OPSORO/Ono2/Other components/RaspberryPi-B+/raspberry_pi_B+_(RENDER).JPG

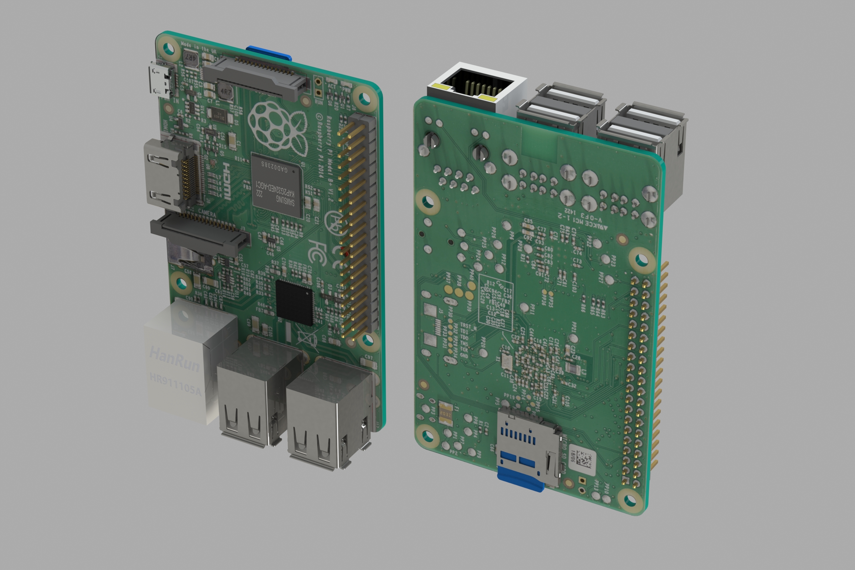
Other components/RaspberryPi-B+/raspberry_pi_B+_(RENDER).JPG
