OPSORO/Ono2/Other components/RaspberryPi-B+/raspberry_pi_B+_(gif).gif

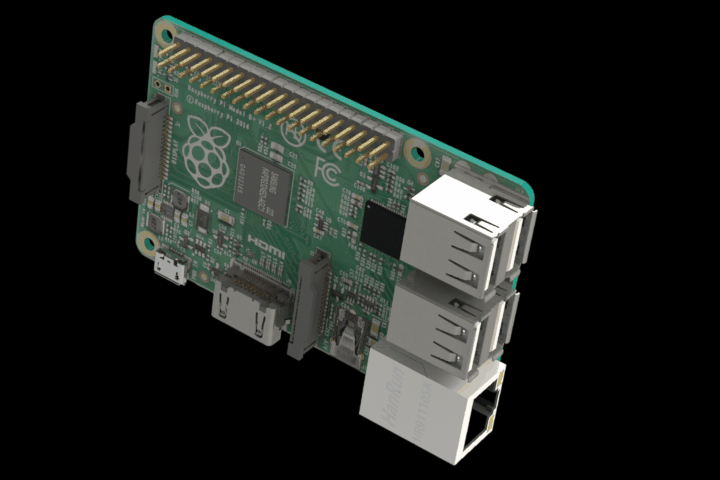
Other components/RaspberryPi-B+/raspberry_pi_B+_(gif).gif
