OPSORO/Ono2/Eye/eye.sldasm

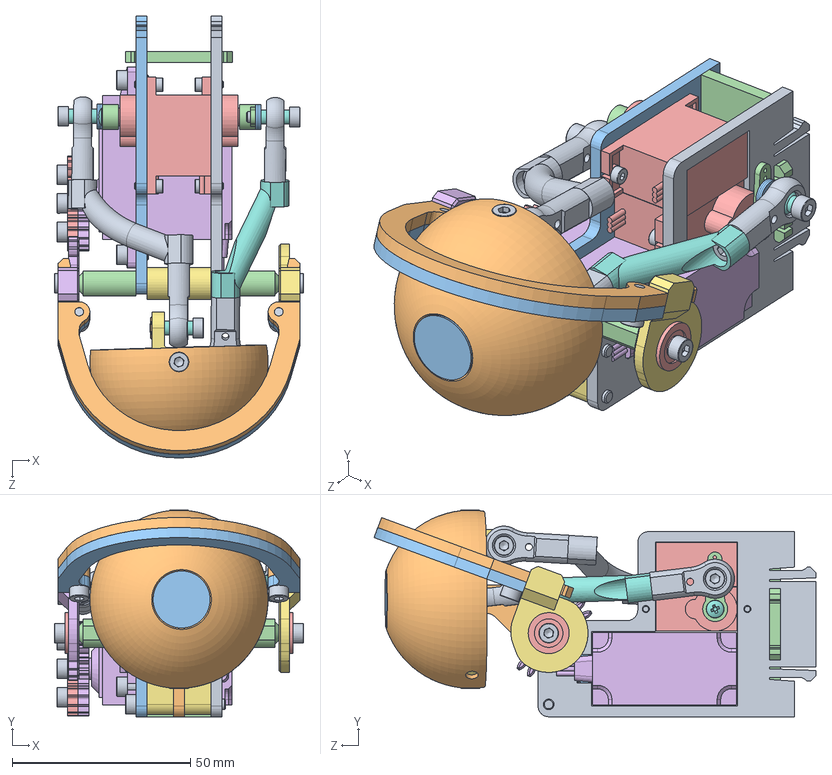
[picture p3: CAD file, 2015-08-11]
Eye/eye.sldasm
70.0 x 58.0 x 124.0 mm
eye-frame-2
eye-frame-4
eye-frame-1
eye-frame-3
servo-micro x 2
servo-standard
pivot-beam
balljoint-ball x 4
balljoint-housing x 4
eye-shell
iris
eyelid-spacer x 2
bearing-f623 x 2
eyelid-gear
eyelid-idler
lever-horizontal
lever-vertical
eyelid
eyelid-lower
servo-horn-micro-1-arm x 2
eyelid-servo-gear-lasered-a
eyelid-servo-gear-lasered-b
eye-frame-spacer x 2
pan head cross recess screw_iso x 2
socket head cap screw_iso x 30
hex nut style 1 gradeab_iso x 7
plain washer normal grade a_iso x 10
