OPSORO/Ono2/Frame/frame-laser.SLDASM

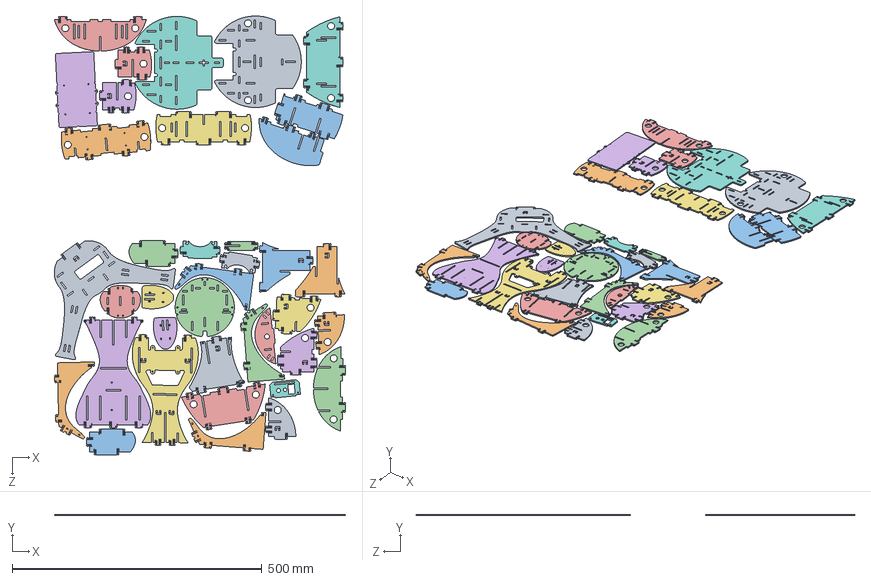
[picture p4: CAD file, 2015-10-12]
Frame/frame-laser.SLDASM
583.5 x 3.00 x 878.7 mm
frame-1-1
frame-1-10
frame-1-2
frame-1-3
frame-1-4
frame-1-5
frame-1-6
frame-1-7
frame-1-8
frame-1-9
frame-1-11
frame-1-12
frame-1-13
frame-1-14
frame-1-15
frame-1-16
frame-1-17
frame-1-18
frame-1-19
frame-2-1
frame-2-2
frame-2-3
frame-2-4
frame-2-5
frame-3-1
frame-3-2
frame-3-3
frame-3-4
frame-3-5
frame-3-6
frame-3-7
frame-4-1
frame-4-2
frame-4-3
frame-4-4
frame-4-5
frame-4-6
frame-5-1
