OPSORO/Ono2/Other components/Workshop-base/workshop-base.SLDASM

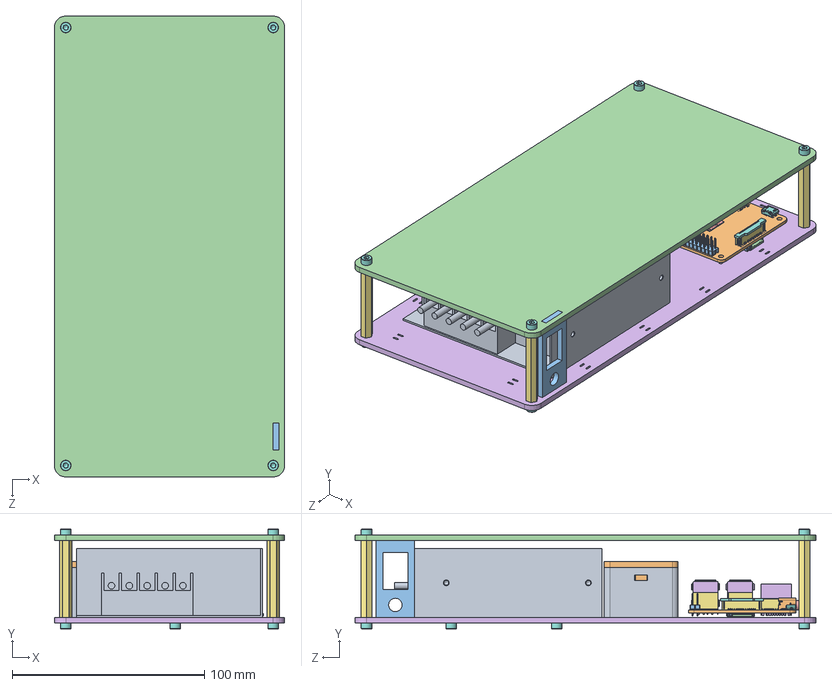
[picture p5: CAD file, 2015-02-17]
Other components/Workshop-base/workshop-base.SLDASM
120.0 x 52.0 x 240.0 mm
psu-tdk-ls50-5
psu-vtx-214-010-105
raspberry_pi_B+_(bar_180_2x20)
raspberry_pi_B+_(QFN64)
raspberry_pi_B+_(168_FBGA_12x12)
raspberry_pi_B+_(USB_x2_part1) x 2
raspberry_pi_B+_(USB_x2_part2) x 2
raspberry_pi_B+_(micro_USB_cover)
raspberry_pi_B+_(micro_USB_contacts)
raspberry_pi__HDMI_socket_cover
raspberry_pi__HDMI_socket_inside
raspberry_pi__HDMI_socket_large_pin x 10
raspberry_pi__HDMI_socket_small_pin x 9
raspberry_pi_B+_(RJ45)
raspberry_pi__15_pin_FFC_Connector_body x 2
raspberry_pi__15_pin_FFC_Connector_locker x 2
raspberry_pi__15_pin_FFC_Connector_pins x 30
raspberry_pi_B+_(CI_Board)
raspberry_pi_B+_(microsd_slot2)
raspberry_pi_B+_(microsd2)
raspberry_pi_B+_(audio_video2)
midplate
standoff-m3x40 x 4
socket head cap screw_iso x 14
psu-spacer x 2
psu-cover
switch-plate
coverplate
