OPSORO/Ono2/Other components/RaspberryPi-B+/raspberry_pi_B+_(microsd).SLDASM

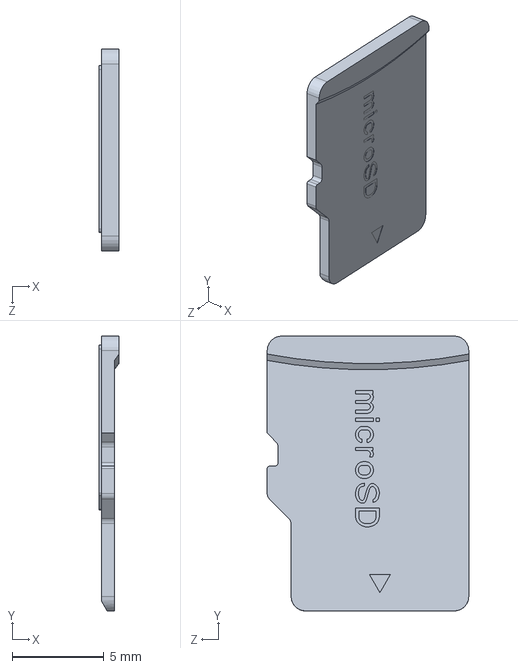
[picture p7: CAD file, 2015-02-17]
Other components/RaspberryPi-B+/raspberry_pi_B+_(microsd).SLDASM
1.10 x 15.0 x 11.0 mm
