OPSORO/Ono2/Other components/RaspberryPi-B+/raspberry_pi_B+_(slot).SLDASM

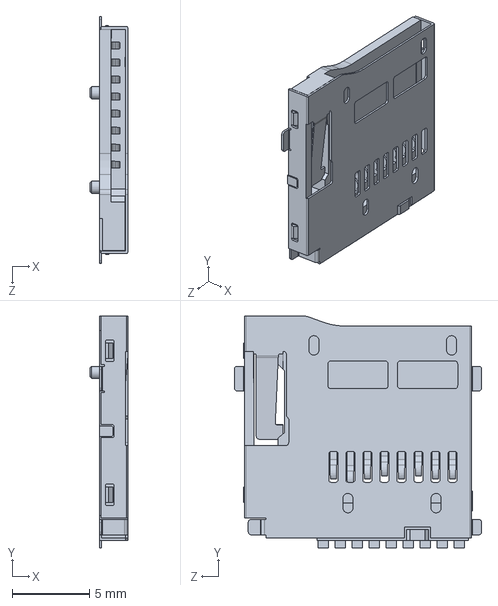
[picture p8: CAD file, 2015-02-17]
Other components/RaspberryPi-B+/raspberry_pi_B+_(slot).SLDASM
2.44 x 15.0 x 16.0 mm
