OPSORO/Ono2/Other components/RaspberryPi-B+/raspberry_pi_B+_(15_pin_FFC_Connector).SLDASM

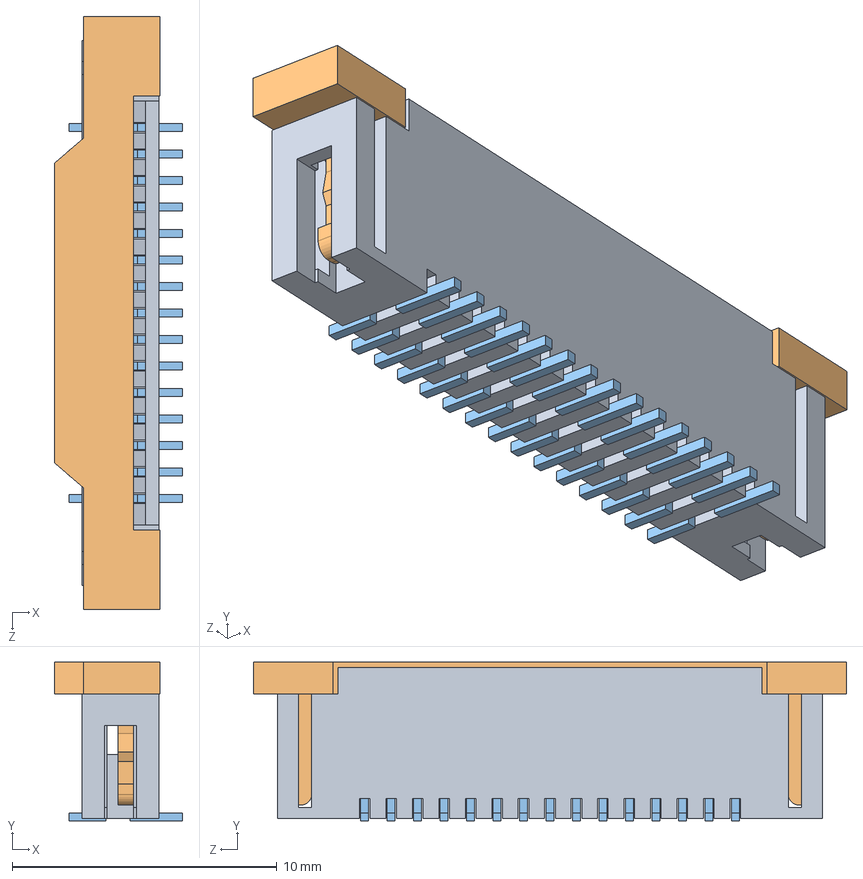
[picture p9: CAD file, 2015-02-17]
Other components/RaspberryPi-B+/raspberry_pi_B+_(15_pin_FFC_Connector).SLDASM
4.85 x 6.00 x 22.4 mm
raspberry_pi__15_pin_FFC_Connector_body
raspberry_pi__15_pin_FFC_Connector_locker
raspberry_pi__15_pin_FFC_Connector_pins x 15
