OPSORO/Ono2/Other components/RaspberryPi-B+/raspberry_pi_B+_(microsd_slot).SLDASM

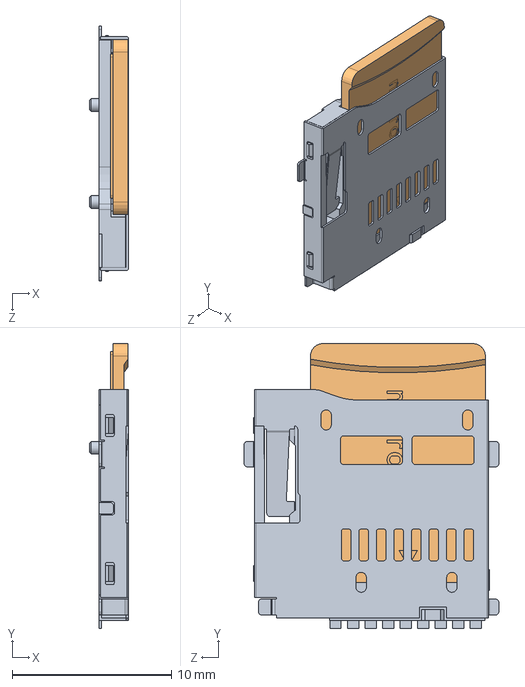
[picture p10: CAD file, 2015-02-17]
Other components/RaspberryPi-B+/raspberry_pi_B+_(microsd_slot).SLDASM
2.44 x 17.9 x 16.0 mm
raspberry_pi_B+_(slot)
raspberry_pi_B+_(microsd)
