OPSORO/Ono2/Other components/RaspberryPi-B+/raspberry_pi_B+_(micro_USB).SLDASM

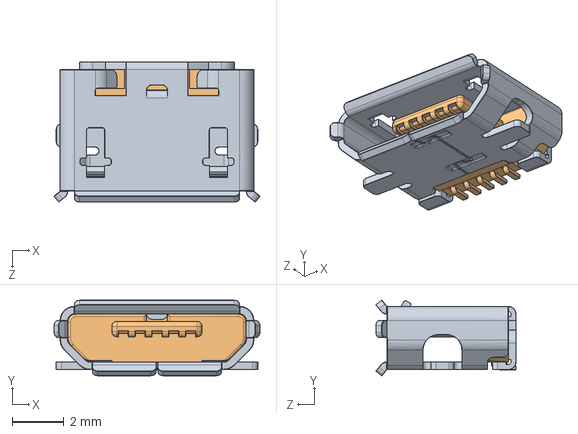
[picture p11: CAD file, 2015-02-17]
Other components/RaspberryPi-B+/raspberry_pi_B+_(micro_USB).SLDASM
7.97 x 2.92 x 5.43 mm
raspberry_pi_B+_(micro_USB_cover)
raspberry_pi_B+_(micro_USB_contacts)
