OPSORO/Ono2/Other components/RaspberryPi-B+/raspberry_pi_B+_(USB_x2).SLDASM

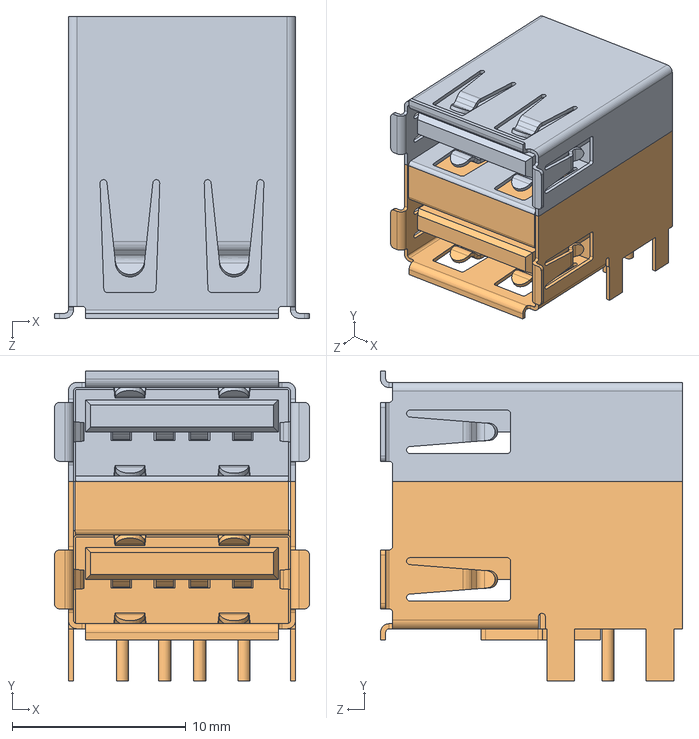
[picture p13: CAD file, 2015-02-17]
Other components/RaspberryPi-B+/raspberry_pi_B+_(USB_x2).SLDASM
14.7 x 17.9 x 17.4 mm
raspberry_pi_B+_(USB_x2_part1)
raspberry_pi_B+_(USB_x2_part2)
