OPSORO/Ono2/STL/ono - raspberrypi_b_+_(assembly)-1 raspberry_pi_B+_(RJ45)-1-1.STL

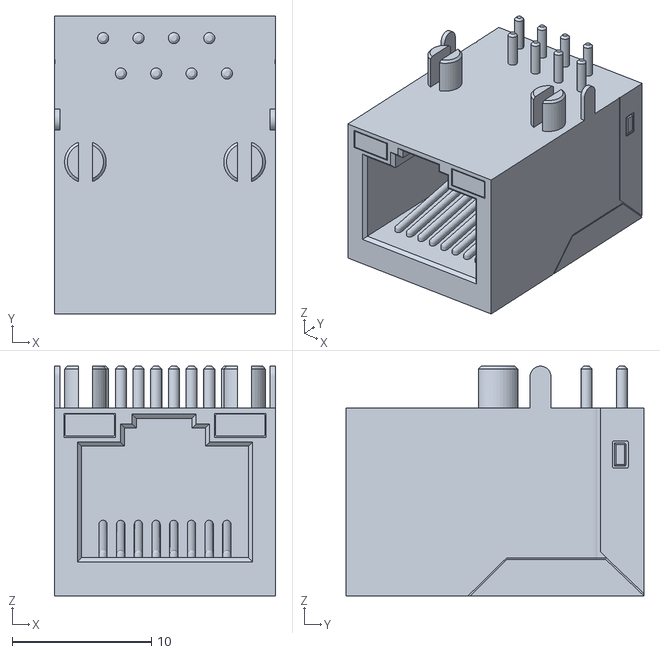
[picture p14: CAD file, 2015-08-11]
STL/ono - raspberrypi_b_+_(assembly)-1 raspberry_pi_B+_(RJ45)-1-1.STL
15.9 x 21.4 x 16.5
