OPSORO/Ono2/STL/ono - raspberrypi_b_+_(assembly)-1 raspberry_pi_B+_(audio_video2)-1-1.STL

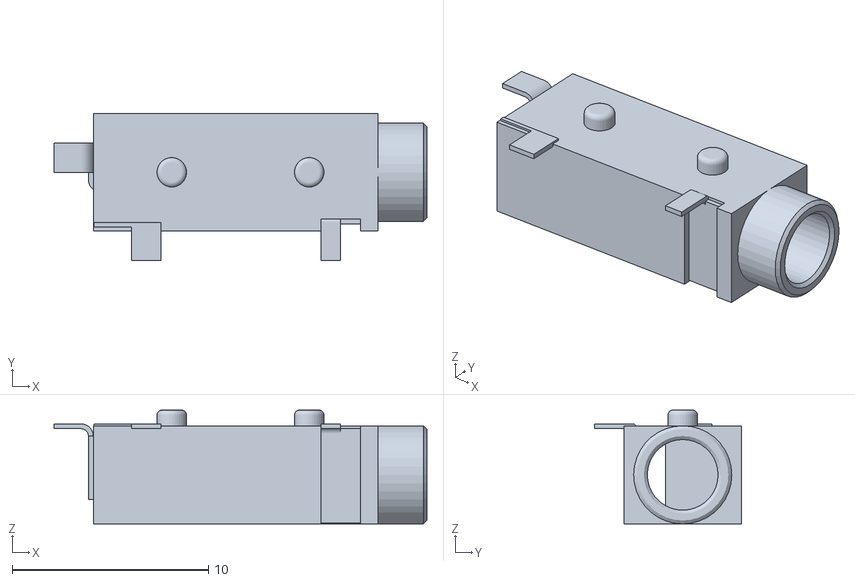
[picture p16: CAD file, 2015-08-11]
STL/ono - raspberrypi_b_+_(assembly)-1 raspberry_pi_B+_(audio_video2)-1-1.STL
19.0 x 7.50 x 5.80
