OPSORO/Ono2/STL/ono - raspberrypi_b_+_(assembly)-1 raspberry_pi_B+_(microsd2)-1-1.STL

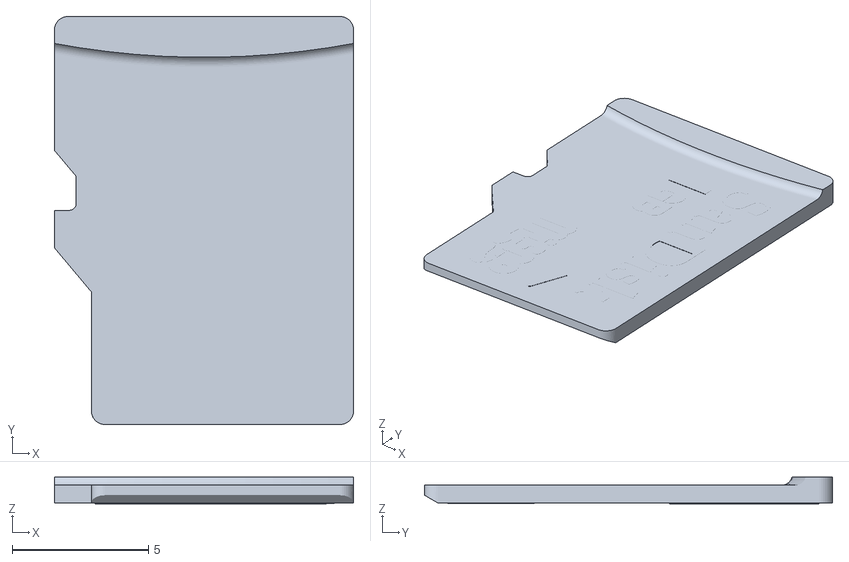
[picture p17: CAD file, 2015-08-11]
STL/ono - raspberrypi_b_+_(assembly)-1 raspberry_pi_B+_(microsd2)-1-1.STL
11.0 x 15.0 x 0.975
