OPSORO/Ono2/STL/ono - raspberrypi_b_+_(assembly)-1 raspberry_pi_B+_(microsd_slot2)-1-1.STL

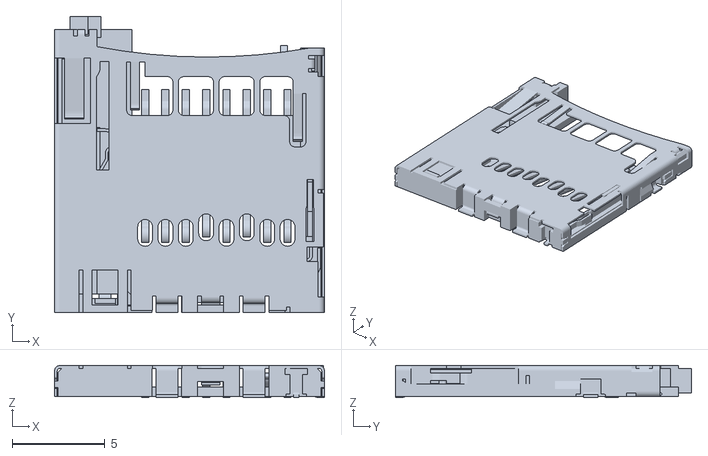
[picture p18: CAD file, 2015-08-11]
STL/ono - raspberrypi_b_+_(assembly)-1 raspberry_pi_B+_(microsd_slot2)-1-1.STL
14.6 x 16.0 x 1.73
