OPSORO/Ono2/STL/ono - raspberrypi_b_+_(assembly)-1 raspberry_pi_B+_(CI_Board)-1-1.STL

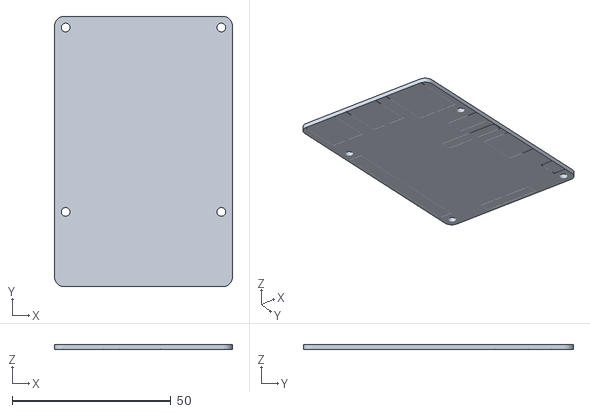
[picture p19: CAD file, 2015-08-11]
STL/ono - raspberrypi_b_+_(assembly)-1 raspberry_pi_B+_(CI_Board)-1-1.STL
56.0 x 85.0 x 1.60
