OPSORO/Ono2/STL/ono - raspberrypi_b_+_(assembly)-1 raspberry_pi_B+_(QFN64)-1-1.STL

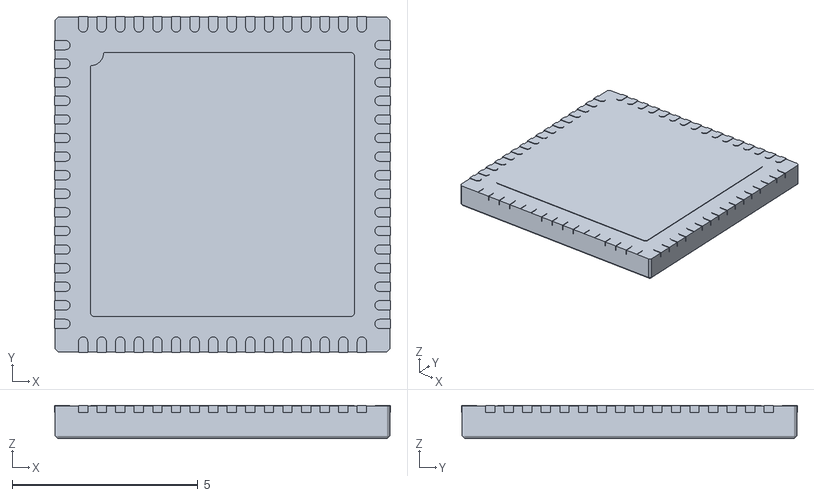
[picture p20: CAD file, 2015-08-11]
STL/ono - raspberrypi_b_+_(assembly)-1 raspberry_pi_B+_(QFN64)-1-1.STL
9.04 x 9.04 x 0.9
