OPSORO/Ono2/STL/ono - raspberrypi_b_+_(assembly)-1 raspberry_pi_B+_(bar_180_2x20)-1-1.STL

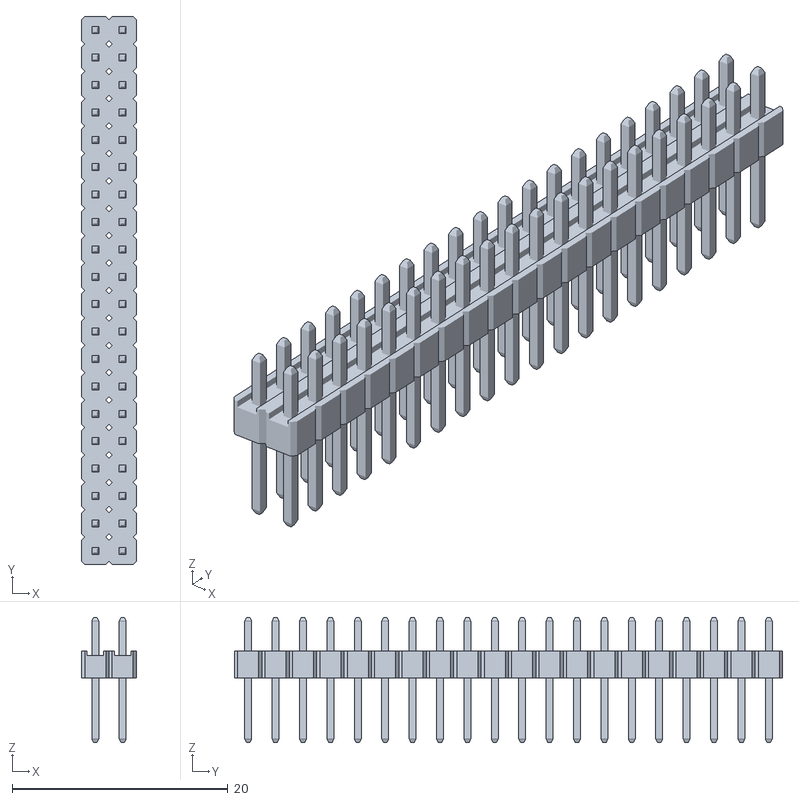
[picture p21: CAD file, 2015-08-11]
STL/ono - raspberrypi_b_+_(assembly)-1 raspberry_pi_B+_(bar_180_2x20)-1-1.STL
5.08 x 50.8 x 11.6
