OPSORO/Ono2/STL/ono - raspberrypi_b_+_(assembly)-1 raspberry_pi_B+_(HDMI_socket)-1 raspberry_pi__HDMI_socket_large_pin-2-1.STL

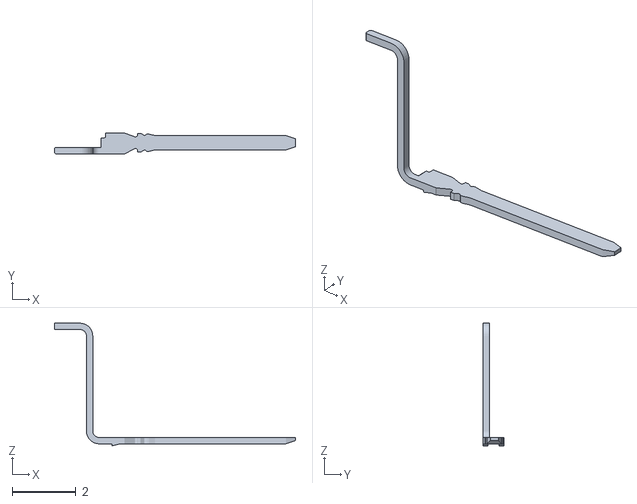
[picture p22: CAD file, 2015-08-07]
STL/ono - raspberrypi_b_+_(assembly)-1 raspberry_pi_B+_(HDMI_socket)-1 raspberry_pi__HDMI_socket_large_pin-2-1.STL
7.55 x 0.65 x 3.84
