OPSORO/Ono2/STL/ono - raspberrypi_b_+_(assembly)-1 raspberry_pi_B+_(15_pin_FFC_Connector)-1 raspberry_pi__15_pin_FFC_Connector_body-1-1.STL

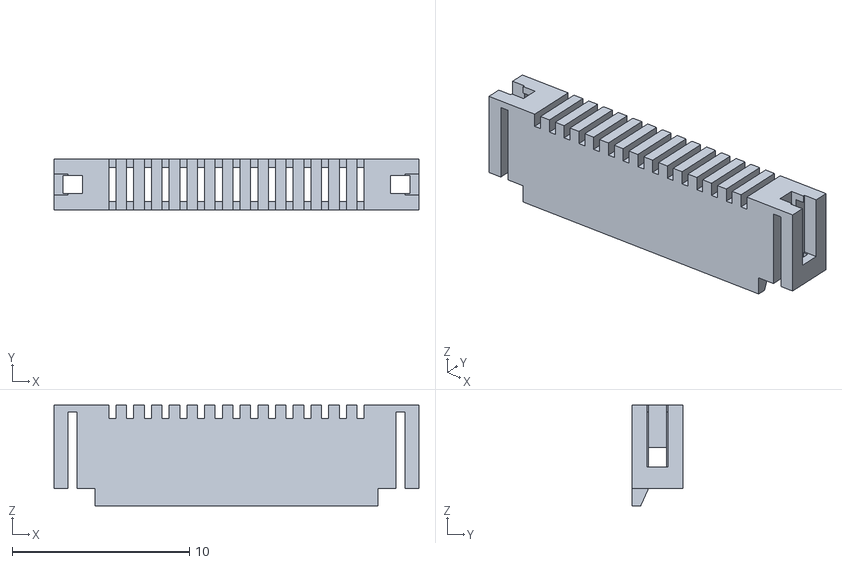
[picture p23: CAD file, 2015-08-07]
STL/ono - raspberrypi_b_+_(assembly)-1 raspberry_pi_B+_(15_pin_FFC_Connector)-1 raspberry_pi__15_pin_FFC_Connector_body-1-1.STL
20.6 x 2.90 x 5.70
