OPSORO/Ono2/STL/ono - raspberrypi_b_+_(assembly)-1 raspberry_pi_B+_(15_pin_FFC_Connector)-2 raspberry_pi__15_pin_FFC_Connector_pins-11-1.STL

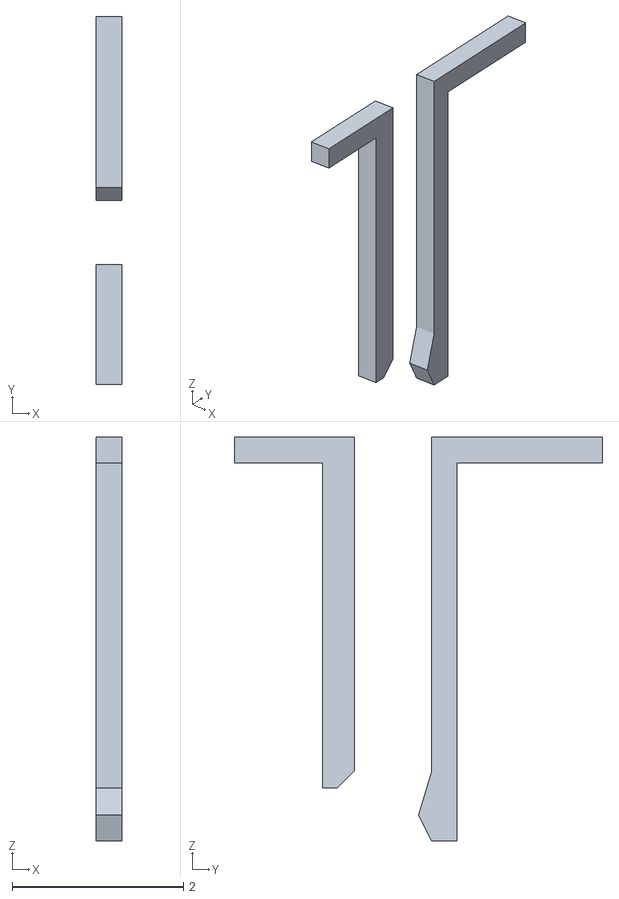
[picture p24: CAD file, 2015-08-07]
STL/ono - raspberrypi_b_+_(assembly)-1 raspberry_pi_B+_(15_pin_FFC_Connector)-2 raspberry_pi__15_pin_FFC_Connector_pins-11-1.STL
0.3 x 4.30 x 4.71
