OPSORO/Ono2/STL/ono - raspberrypi_b_+_(assembly)-1 raspberry_pi_B+_(HDMI_socket)-1 raspberry_pi__HDMI_socket_cover-1-1.STL

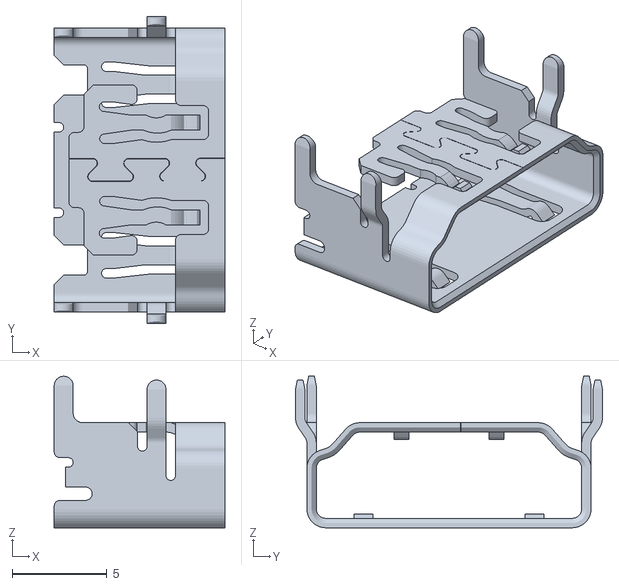
[picture p25: CAD file, 2015-08-07]
STL/ono - raspberrypi_b_+_(assembly)-1 raspberry_pi_B+_(HDMI_socket)-1 raspberry_pi__HDMI_socket_cover-1-1.STL
9.00 x 16.2 x 8.00
