OPSORO/Ono2/STL/ono - raspberrypi_b_+_(assembly)-1 raspberry_pi_B+_(USB_x2)-2 raspberry_pi_B+_(USB_x2_part1)-1-1.STL

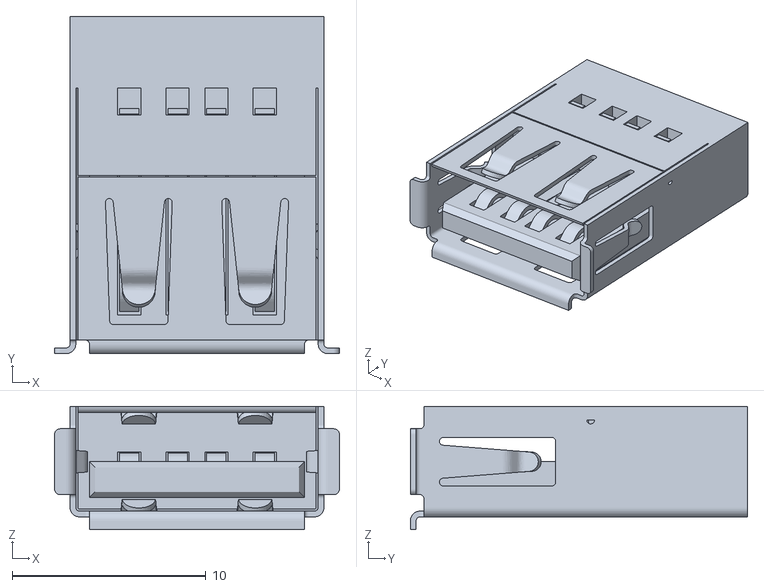
[picture p26: CAD file, 2015-08-07]
STL/ono - raspberrypi_b_+_(assembly)-1 raspberry_pi_B+_(USB_x2)-2 raspberry_pi_B+_(USB_x2_part1)-1-1.STL
14.7 x 17.4 x 6.35
