OPSORO/Ono2/STL/ono - raspberrypi_b_+_(assembly)-1 raspberry_pi_B+_(15_pin_FFC_Connector)-2 raspberry_pi__15_pin_FFC_Connector_locker-1-1.STL

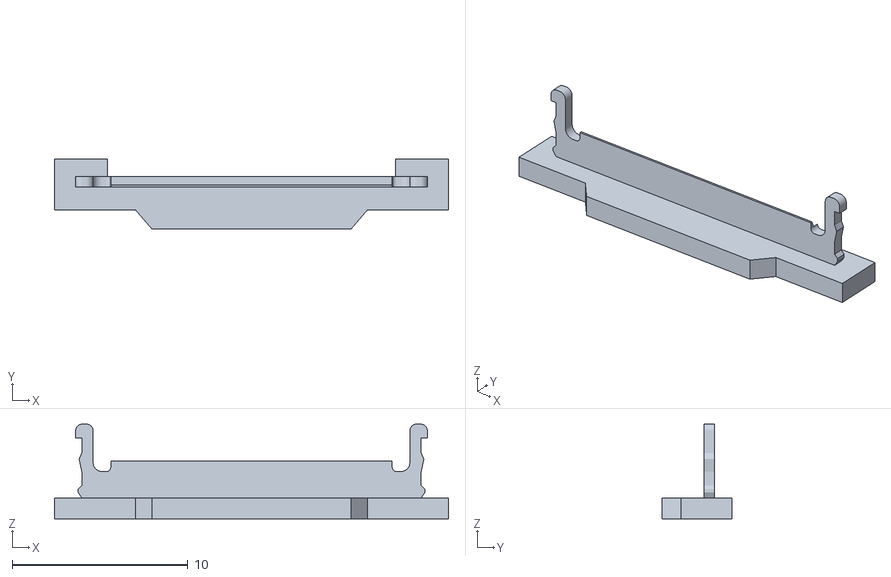
[picture p28: CAD file, 2015-08-07]
STL/ono - raspberrypi_b_+_(assembly)-1 raspberry_pi_B+_(15_pin_FFC_Connector)-2 raspberry_pi__15_pin_FFC_Connector_locker-1-1.STL
22.4 x 4.00 x 5.40
