OPSORO/Ono2/STL/ono - raspberrypi_b_+_(assembly)-1 raspberry_pi_B+_(micro_USB)-1 raspberry_pi_B+_(micro_USB_contacts)-1-1.STL

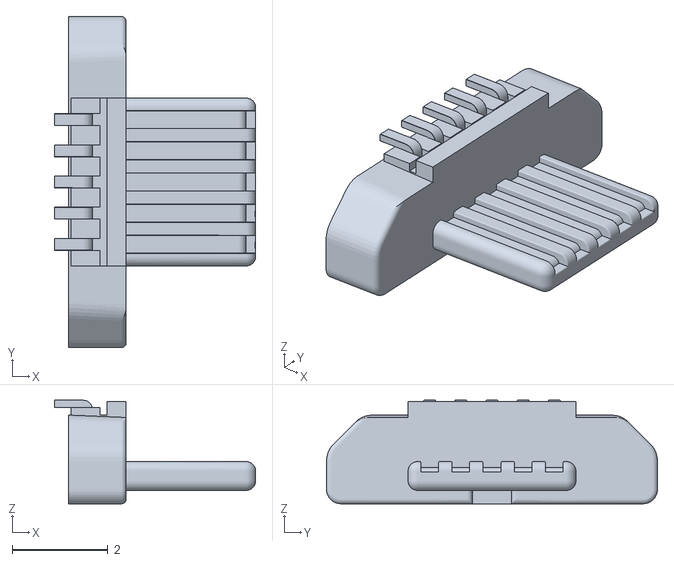
[picture p30: CAD file, 2015-08-07]
STL/ono - raspberrypi_b_+_(assembly)-1 raspberry_pi_B+_(micro_USB)-1 raspberry_pi_B+_(micro_USB_contacts)-1-1.STL
4.20 x 6.90 x 2.16
