OPSORO/Ono2/STL/ono - raspberrypi_b_+_(assembly)-1 raspberry_pi_B+_(HDMI_socket)-1 raspberry_pi__HDMI_socket_inside-1-1.STL

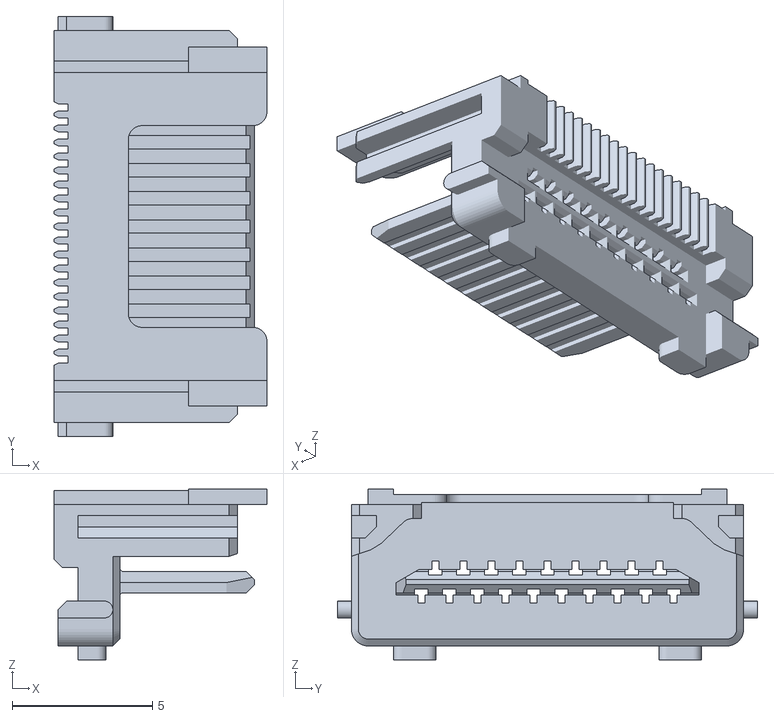
[picture p31: CAD file, 2015-08-07]
STL/ono - raspberrypi_b_+_(assembly)-1 raspberry_pi_B+_(HDMI_socket)-1 raspberry_pi__HDMI_socket_inside-1-1.STL
7.60 x 15.0 x 6.10
