OPSORO/Ono2/STL/ono - raspberrypi_b_+_(assembly)-1 raspberry_pi_B+_(micro_USB)-1 raspberry_pi_B+_(micro_USB_cover)-1-1.STL

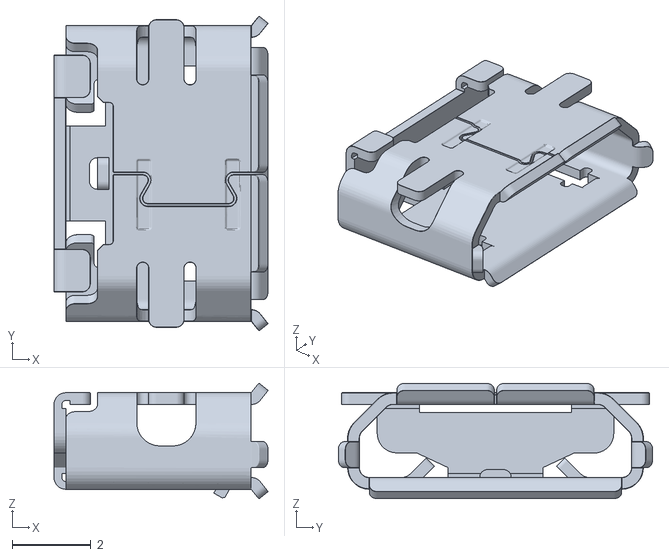
[picture p32: CAD file, 2015-08-07]
STL/ono - raspberrypi_b_+_(assembly)-1 raspberry_pi_B+_(micro_USB)-1 raspberry_pi_B+_(micro_USB_cover)-1-1.STL
5.43 x 7.97 x 2.92
