OPSORO/Ono2/Eye/DXF/eye-laser.dxf

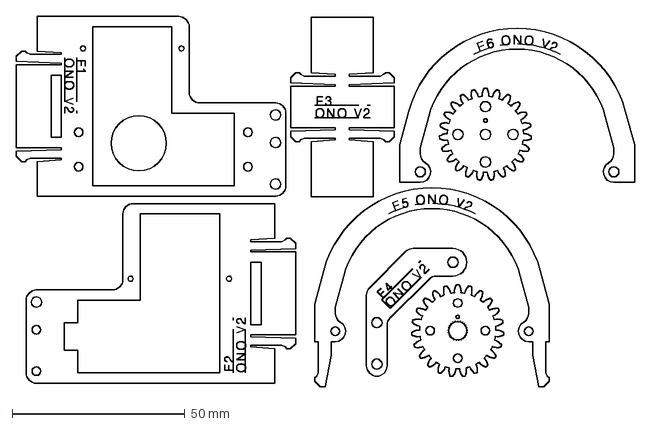
[picture p33: CAD file, 2015-08-11]
Eye/DXF/eye-laser.dxf
178.9 x 107.1 mm
