OPSORO/Ono2/Eye/STEP/eyelid-idler-r.step

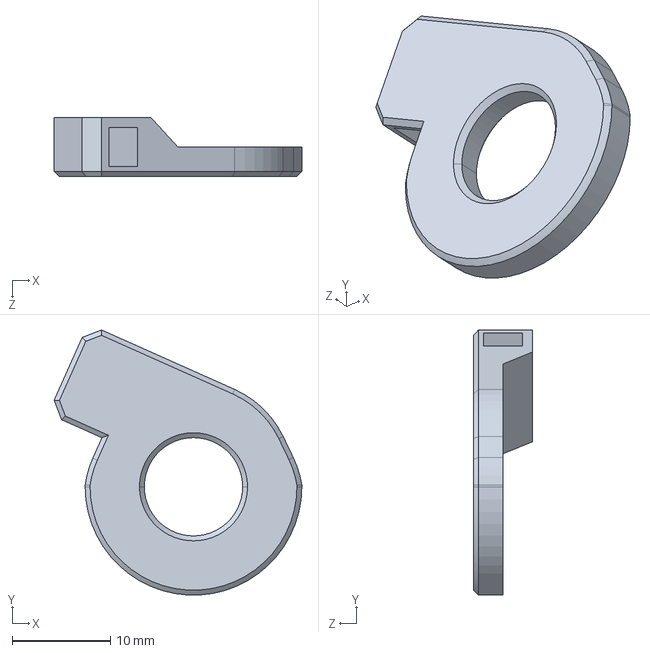
[picture p34: CAD file, 2015-08-11]
Eye/STEP/eyelid-idler-r.step
25.2 x 27.0 x 6.00 mm
