OPSORO/Ono2/Eye/STL/eye - eye-frame-spacer-3.STL

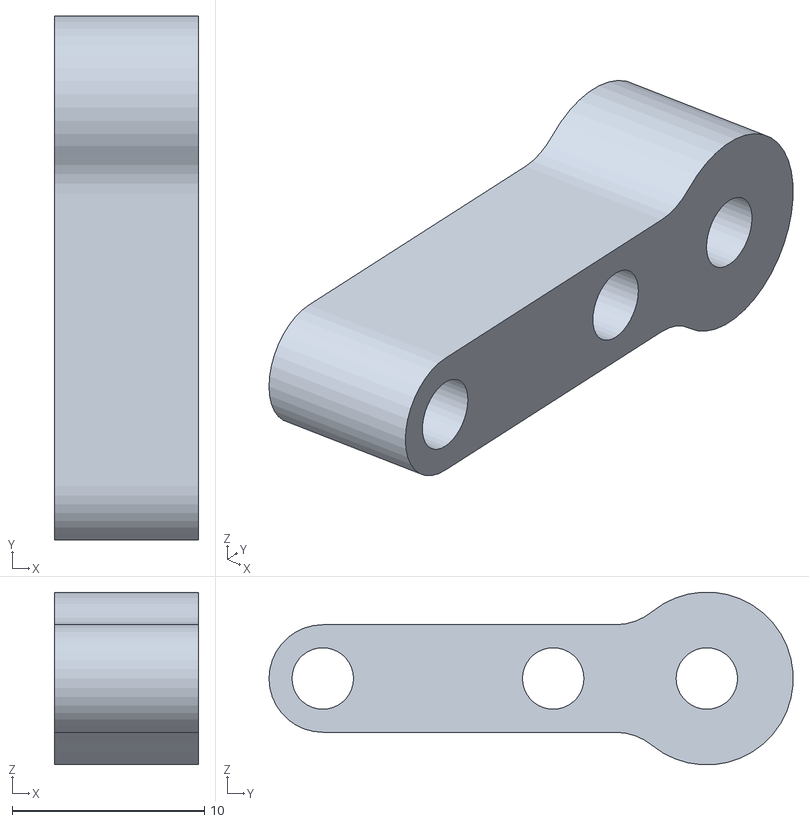
[picture p35: CAD file, 2015-08-11]
Eye/STL/eye - eye-frame-spacer-3.STL
7.50 x 27.3 x 8.98
