OPSORO/Ono2/Eyebrow/DXF/eyebrow-laser.dxf

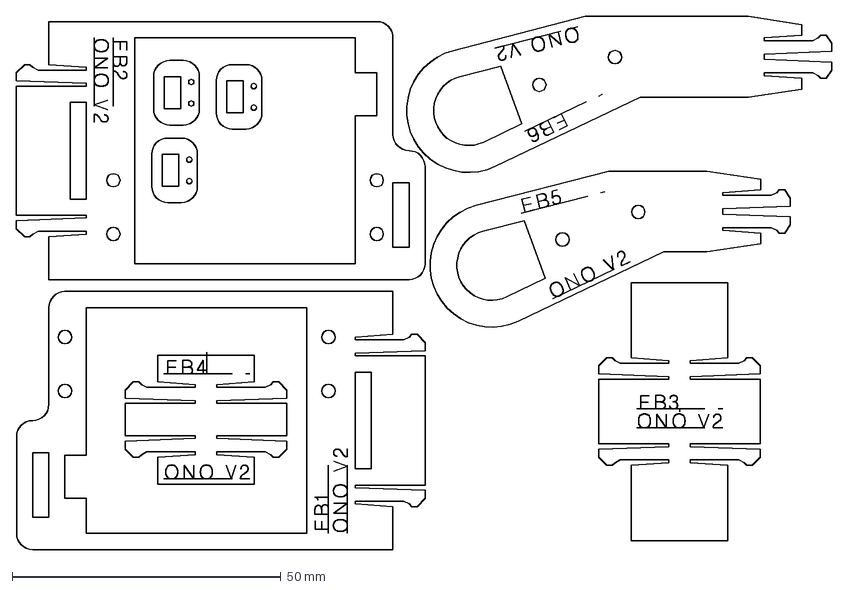
[picture p36: CAD file, 2015-08-11]
Eyebrow/DXF/eyebrow-laser.dxf
151.6 x 99.1 mm
