OPSORO/Ono2/Eyebrow/lever-outer-towerpro-horn.SLDPRT

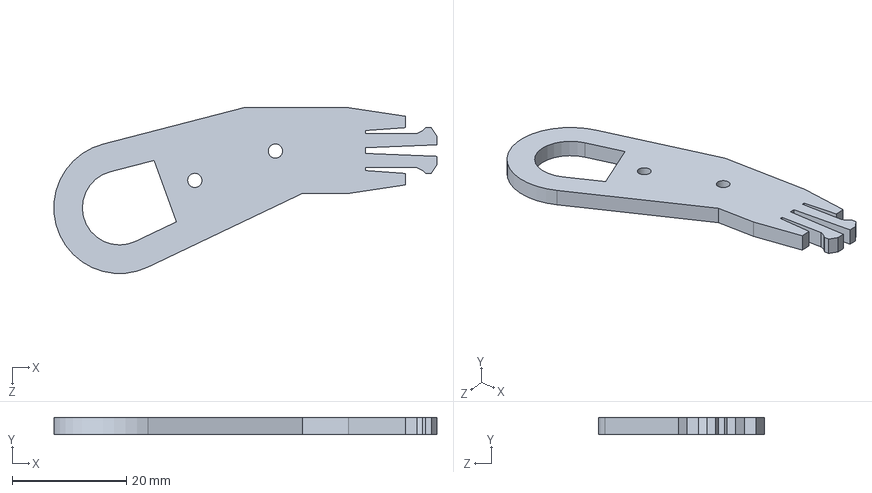
[picture p37: CAD file, 2015-08-10]
Eyebrow/lever-outer-towerpro-horn.SLDPRT
67.0 x 3.00 x 29.0 mm
