OPSORO/Ono2/Eyebrow/STEP/eyebrow.step

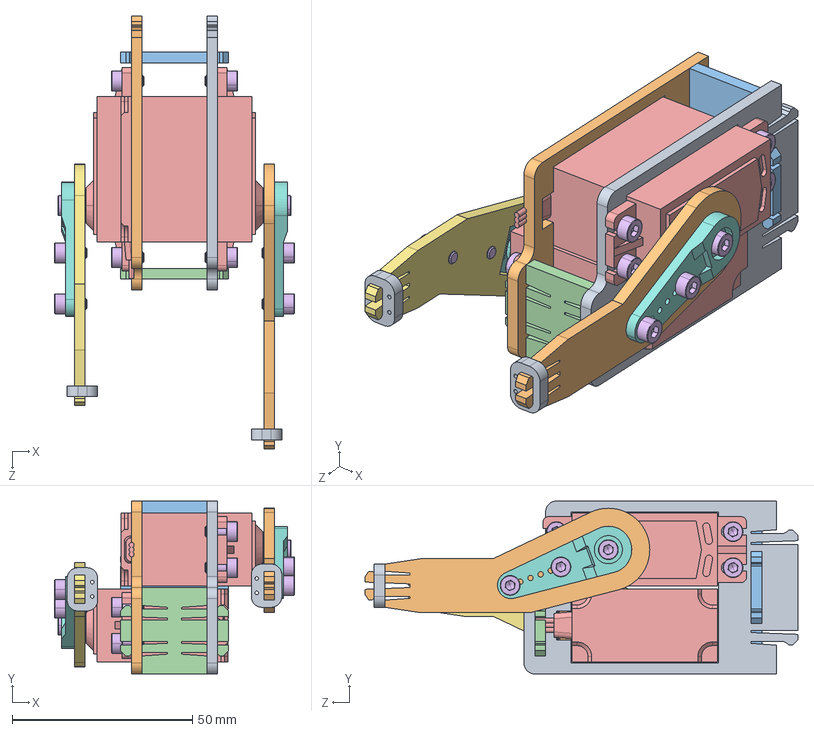
[picture p38: CAD file, 2015-08-10]
Eyebrow/STEP/eyebrow.step
66.6 x 48.0 x 120.1 mm
eyebrow-frame-1
eyebrow-frame-2
eyebrow-frame-3
eyebrow-frame-4
servo-standard x 2
socket head cap screw_iso_ISO 4762 M3 x 6 --- 6N x 14
lever-outer-towerpro-horn
servo-horn-towerpro-1-arm x 2
textile-snap x 2
lever-inner-towerpro-horn
