OPSORO/Ono2/Eyebrow/STL/eyebrow - eyebrow-frame-1-1.STL

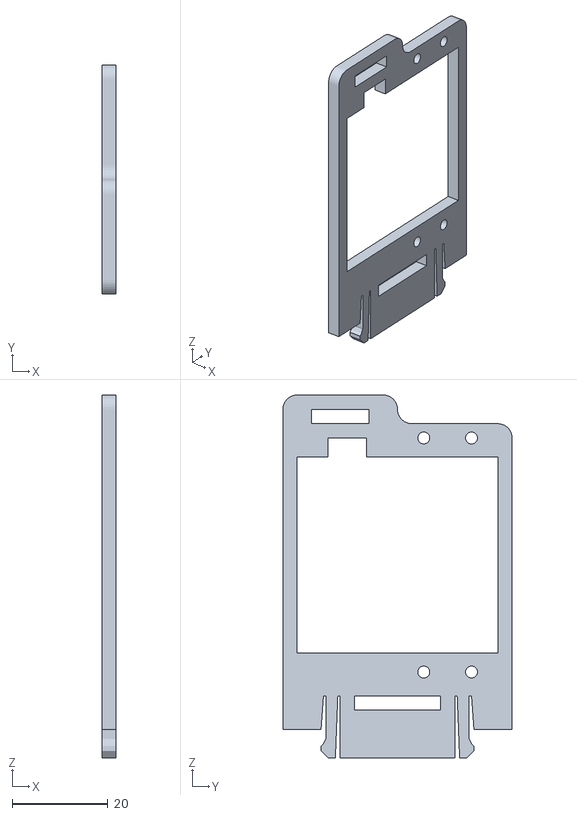
[picture p39: CAD file, 2015-08-10]
Eyebrow/STL/eyebrow - eyebrow-frame-1-1.STL
3.00 x 48.0 x 76.0
