OPSORO/Ono2/Frame/STEP/psu-spacer-new.step

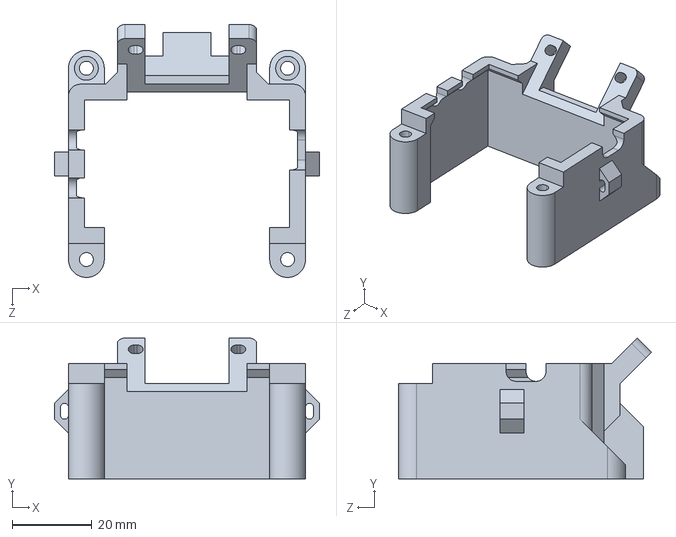
[picture p40: CAD file, 2015-08-07]
Frame/STEP/psu-spacer-new.step
66.5 x 35.4 x 63.5 mm
