OPSORO/Ono2/Mouth/DXF/mouth-laser.dxf

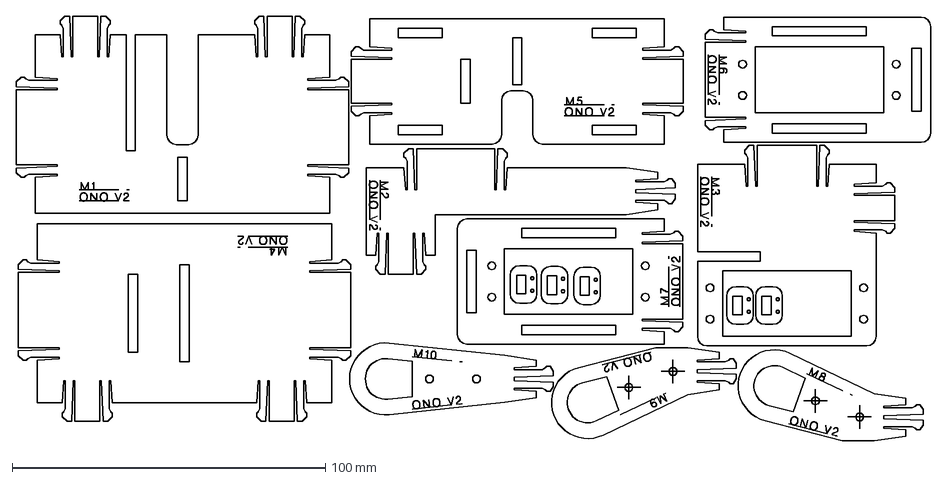
[picture p41: CAD file, 2015-10-12]
Mouth/DXF/mouth-laser.dxf
291.8 x 135.6 mm
