OPSORO/Ono2/Mouth/lever-mid-towerpro-horn.SLDPRT

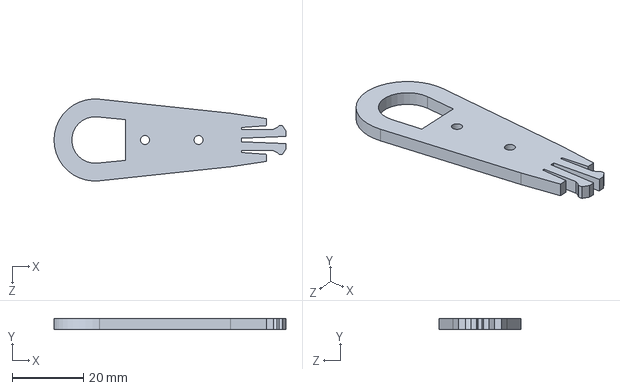
[picture p42: CAD file, 2015-08-10]
Mouth/lever-mid-towerpro-horn.SLDPRT
65.0 x 3.00 x 23.0 mm
