OPSORO/Ono2/Mouth/STL/mouth - textile-snap-5.STL

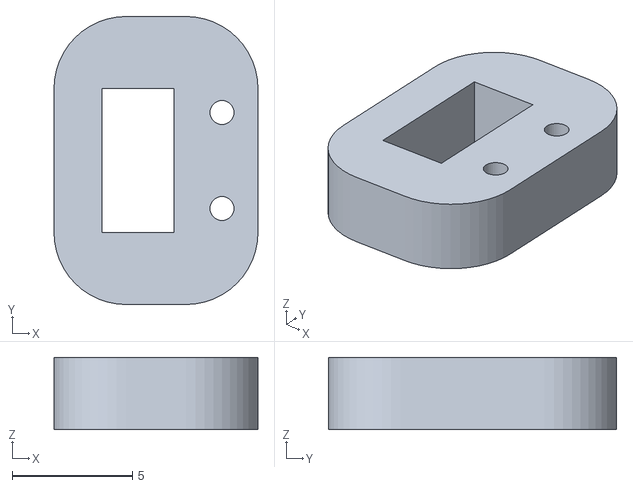
[picture p44: CAD file, 2015-08-10]
Mouth/STL/mouth - textile-snap-5.STL
8.50 x 12.0 x 3.00
