OPSORO/Ono2/Other components/servo-horn-towerpro-1-arm.SLDPRT

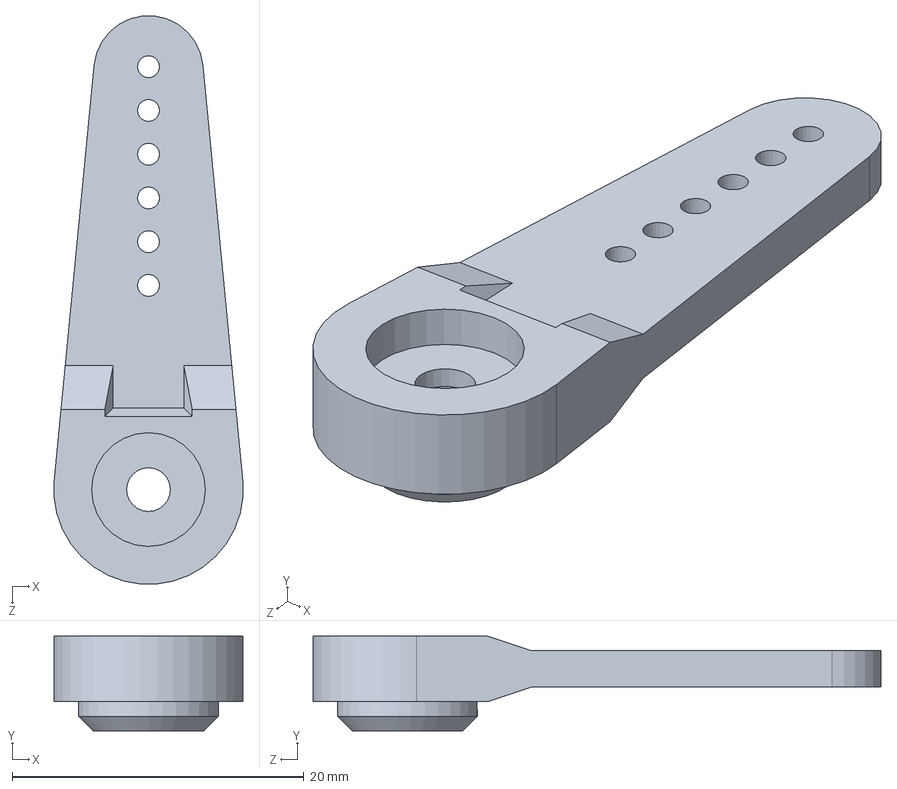
[picture p47: CAD file, 2015-08-10]
Other components/servo-horn-towerpro-1-arm.SLDPRT
13.0 x 6.50 x 39.0 mm
