OPSORO/Ono2/Other components/STEP/switch-arcolectric-h8600vbaaa.step

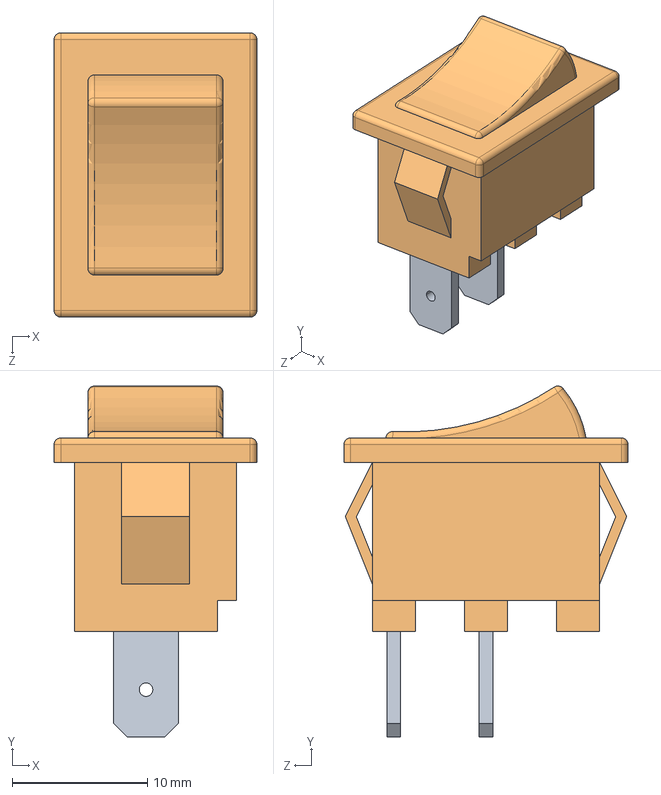
[picture p48: CAD file, 2015-08-07]
Other components/STEP/switch-arcolectric-h8600vbaaa.step
15.0 x 25.9 x 21.0 mm
