OPSORO/Ono2/Other components/STL/balljoint - balljoint-housing-1.STL

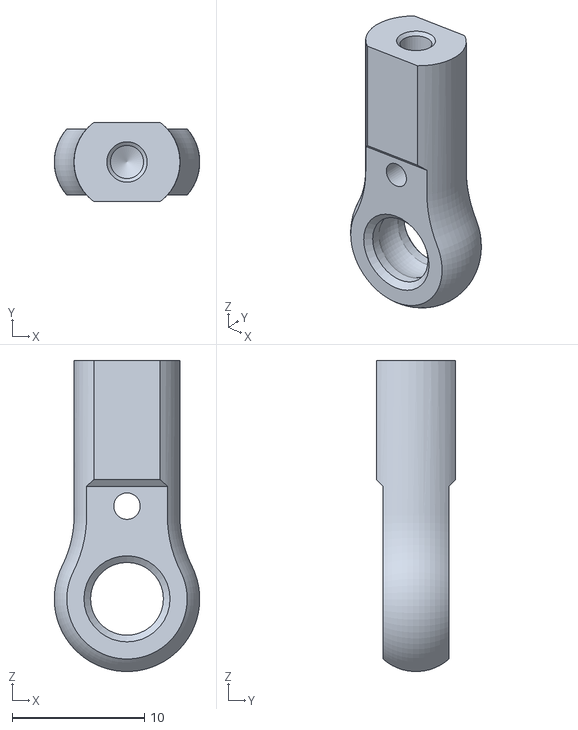
[picture p49: CAD file, 2015-02-17]
Other components/STL/balljoint - balljoint-housing-1.STL
11.0 x 6.00 x 23.5
