OPSORO/Ono2/Other components/Workshop-base/DXF/workshop-base-laser.dxf

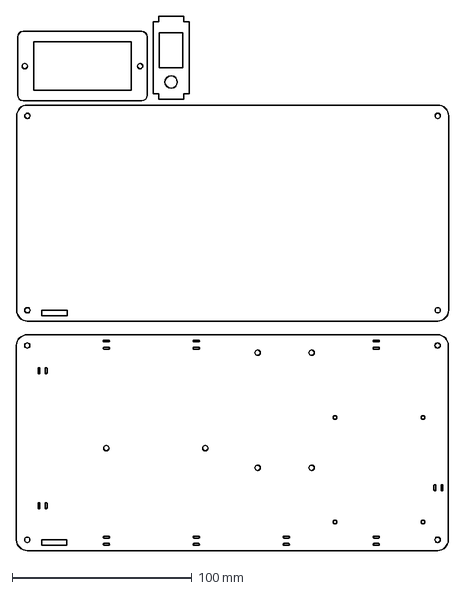
[picture p50: CAD file, 2015-02-17]
Other components/Workshop-base/DXF/workshop-base-laser.dxf
240.1 x 296.9 mm
