OPSORO/Ono2/Other components/Workshop-base/STEP/switch-plate.step

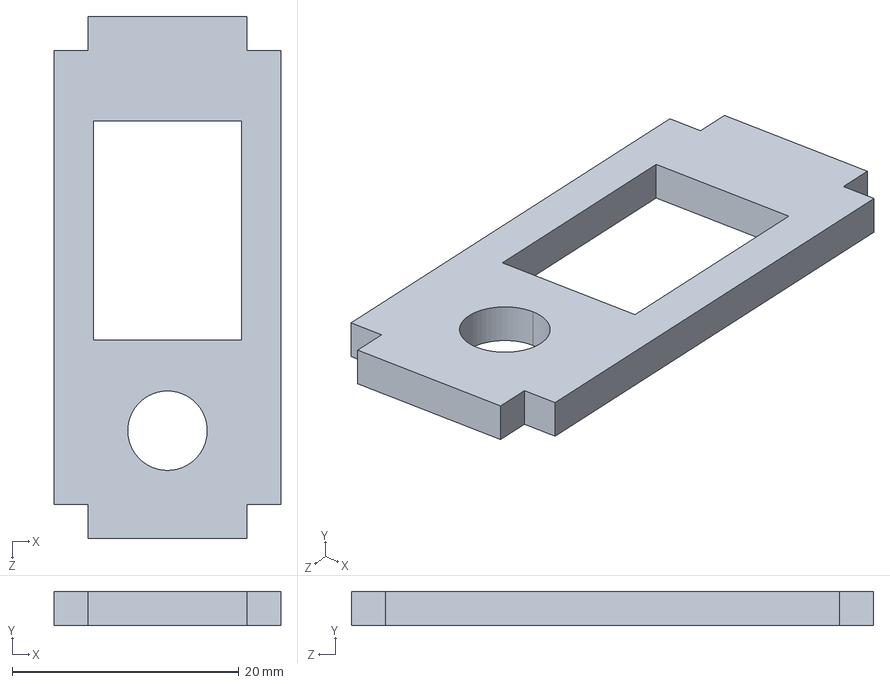
[picture p51: CAD file, 2015-02-17]
Other components/Workshop-base/STEP/switch-plate.step
20.0 x 3.00 x 46.0 mm
