OPSORO/Ono2/Eye/eyelid-servo-gear-lasered-a.SLDPRT

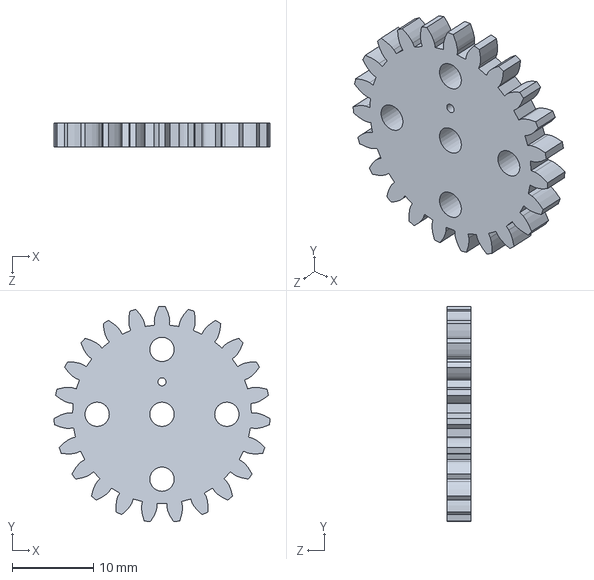
[picture p52: CAD file, 2015-08-11]
Eye/eyelid-servo-gear-lasered-a.SLDPRT
26.6 x 26.6 x 3.00 mm
