OPSORO/Ono2/Eye/STEP/eye-shell-l.step

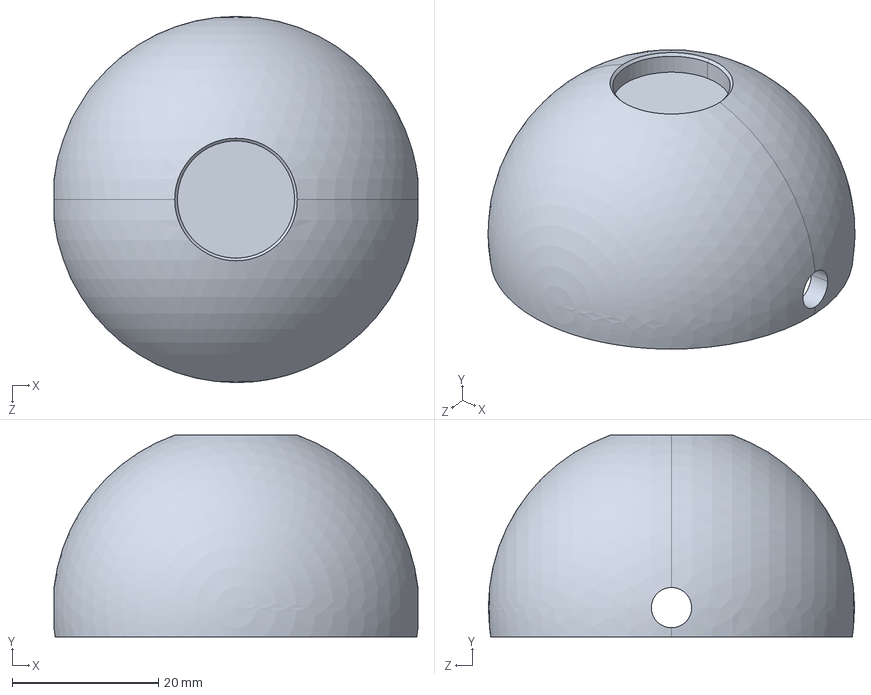
[picture p53: CAD file, 2015-08-11]
Eye/STEP/eye-shell-l.step
49.7 x 27.6 x 50.0 mm
