OPSORO/Ono2/Eyebrow/lever-inner-towerpro-horn.SLDPRT

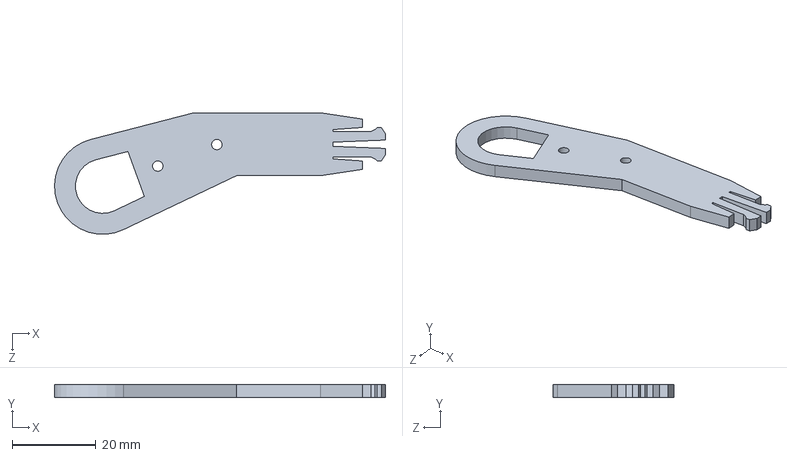
[picture p54: CAD file, 2015-08-10]
Eyebrow/lever-inner-towerpro-horn.SLDPRT
79.0 x 3.00 x 29.0 mm
