OPSORO/Ono2/Eyebrow/STEP/lever-outer.step

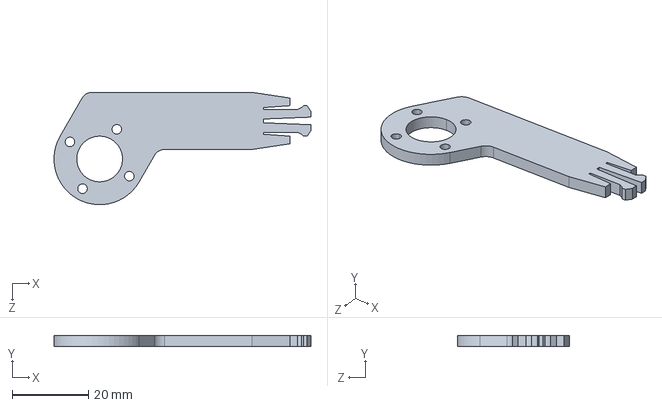
[picture p55: CAD file, 2015-02-17]
Eyebrow/STEP/lever-outer.step
67.5 x 3.00 x 29.5 mm
