OPSORO/Ono2/Mouth/lever-outer-r-towerpro-horn.SLDPRT

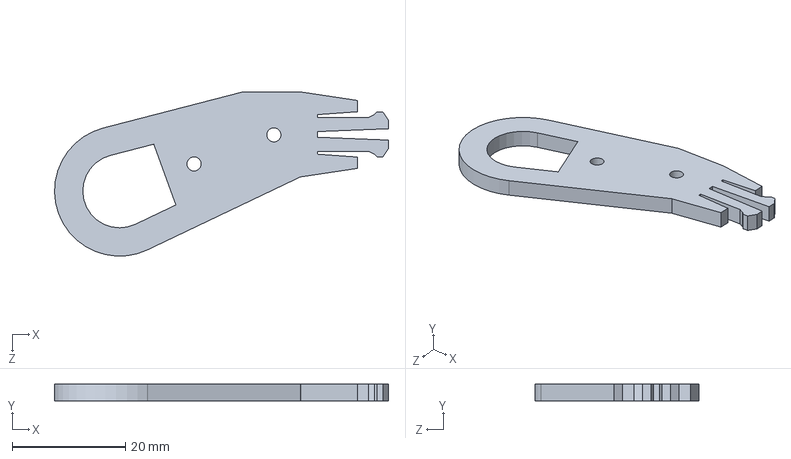
[picture p56: CAD file, 2015-08-10]
Mouth/lever-outer-r-towerpro-horn.SLDPRT
59.0 x 3.00 x 29.0 mm
