OPSORO/Ono2/Mouth/STEP/lever-mid.step

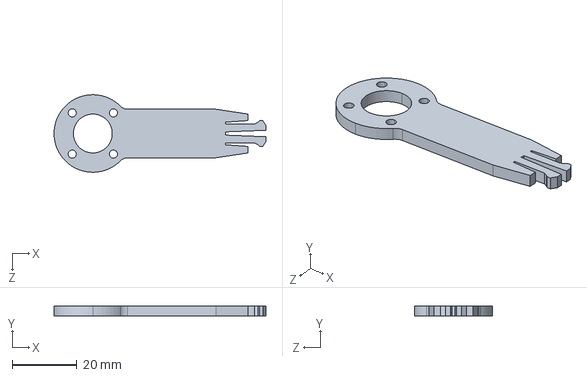
[picture p57: CAD file, 2015-02-17]
Mouth/STEP/lever-mid.step
65.5 x 3.00 x 24.0 mm
