OPSORO/Ono2/Other components/Joint/STL/joint - lever-servo-1.STL

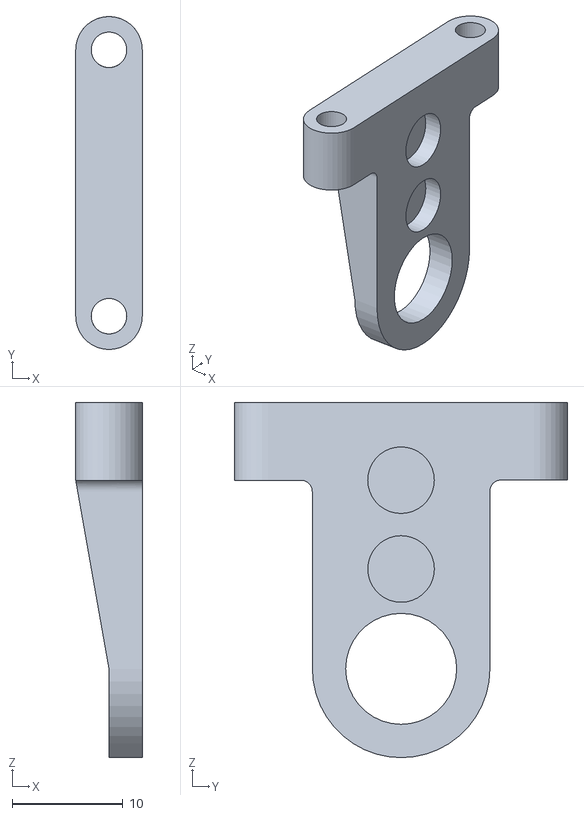
[picture p59: CAD file, 2015-02-17]
Other components/Joint/STL/joint - lever-servo-1.STL
6.00 x 30.0 x 32.0
