OPSORO/Ono2/Other components/led-5mm-red.SLDPRT

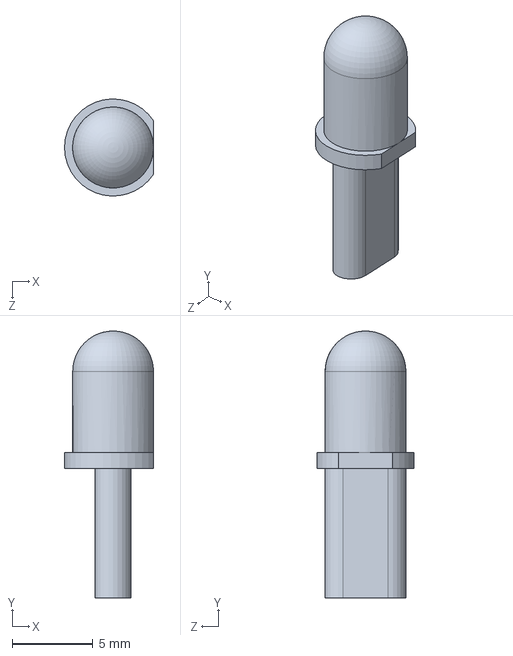
[picture p60: CAD file, 2015-08-07]
Other components/led-5mm-red.SLDPRT
5.50 x 16.5 x 6.00 mm
