OPSORO/Ono2/Other components/STEP/led-holder-kingbright-rtf5010.step

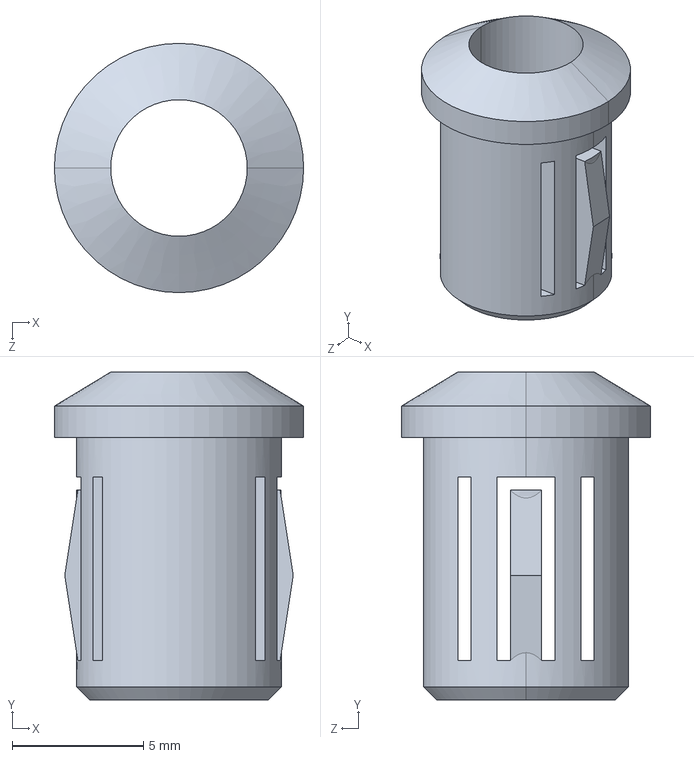
[picture p61: CAD file, 2015-08-07]
Other components/STEP/led-holder-kingbright-rtf5010.step
9.50 x 12.5 x 9.50 mm
