OPSORO/Ono2/Other components/STL/balljoint - balljoint-ball-1.STL

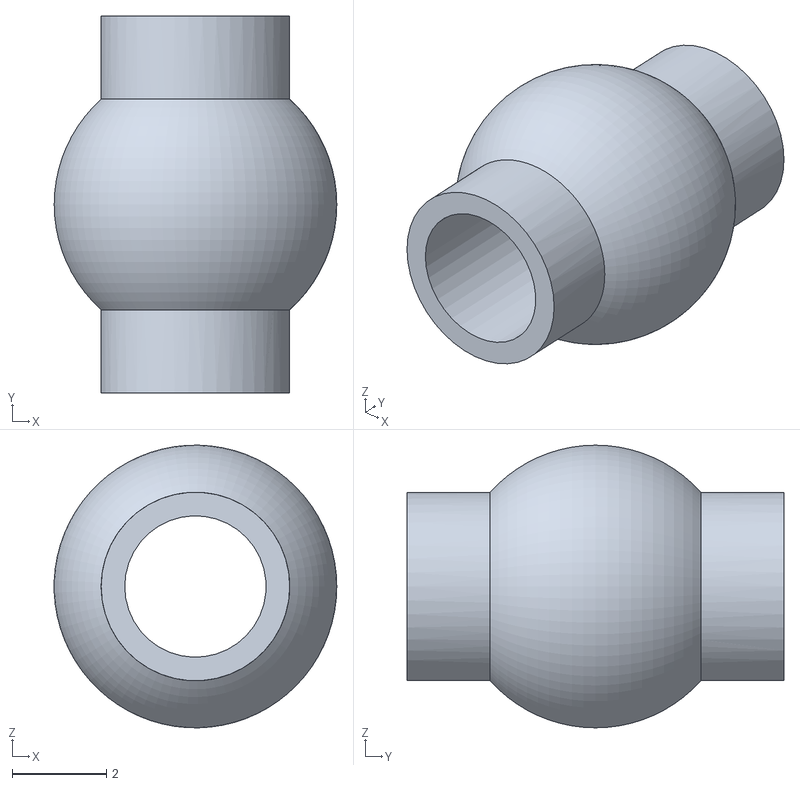
[picture p62: CAD file, 2015-02-17]
Other components/STL/balljoint - balljoint-ball-1.STL
6.00 x 8.00 x 6.00
