OPSORO/Ono2/Other components/Workshop-base/STEP/coverplate.step

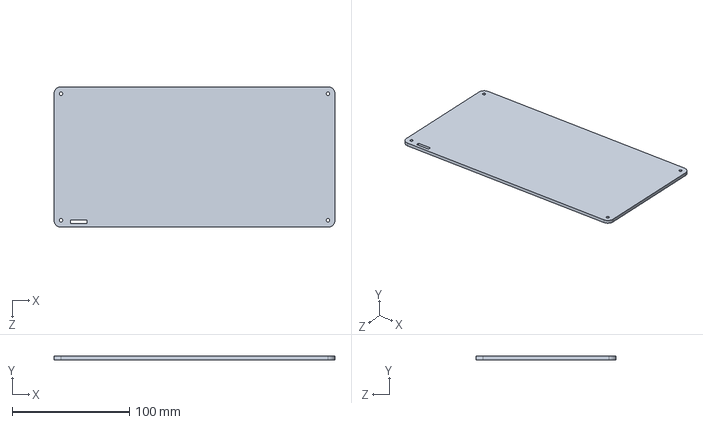
[picture p63: CAD file, 2015-02-17]
Other components/Workshop-base/STEP/coverplate.step
240.0 x 3.00 x 120.0 mm
