OPSORO/Ono2/Eye/STEP/eyelid-gear-r.step

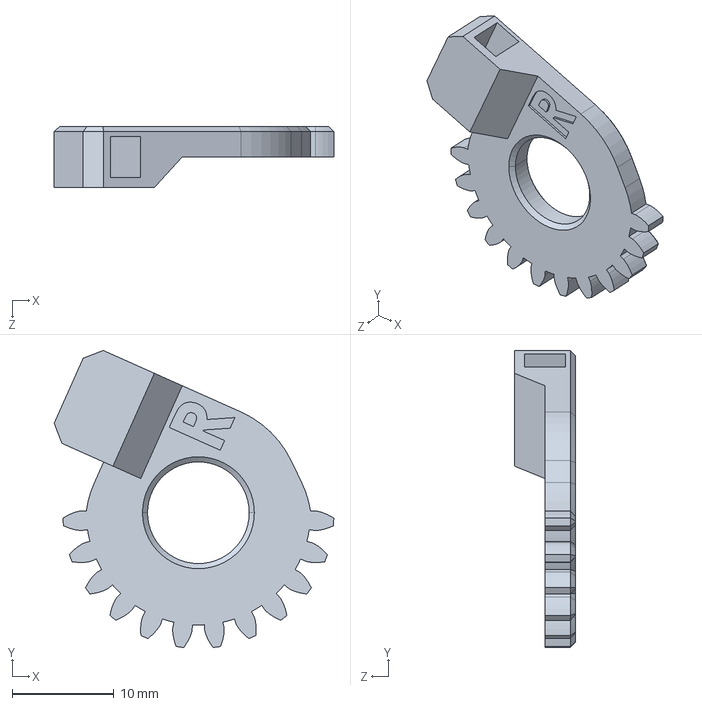
[picture p64: CAD file, 2015-08-11]
Eye/STEP/eyelid-gear-r.step
27.5 x 29.2 x 6.00 mm
