OPSORO/Ono2/Eyebrow/lever-inner-printed-horn.SLDPRT

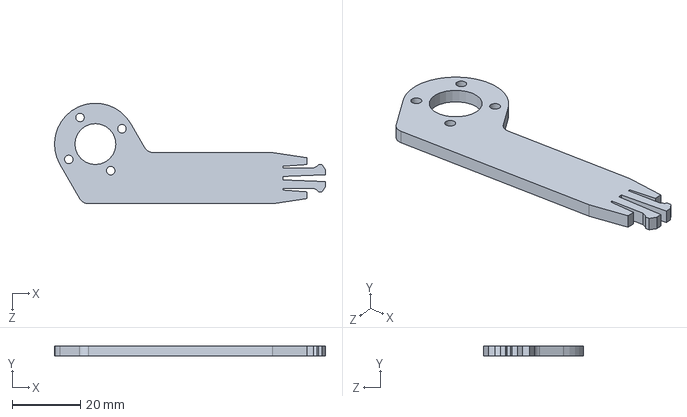
[picture p65: CAD file, 2014-09-25]
Eyebrow/lever-inner-printed-horn.SLDPRT
79.5 x 3.00 x 29.5 mm
