OPSORO/Ono2/Eyebrow/STEP/lever-inner.step

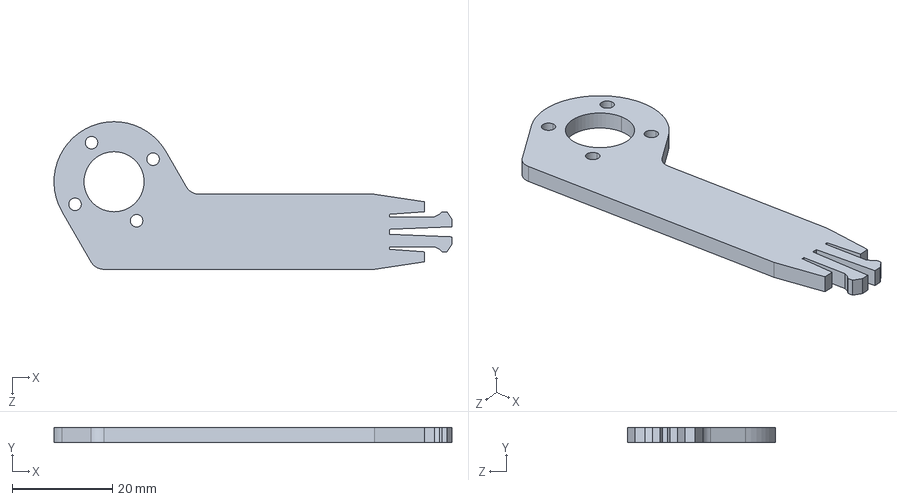
[picture p66: CAD file, 2015-02-17]
Eyebrow/STEP/lever-inner.step
79.5 x 3.00 x 29.5 mm
