OPSORO/Ono2/Frame/STEP/frame-3-7.step

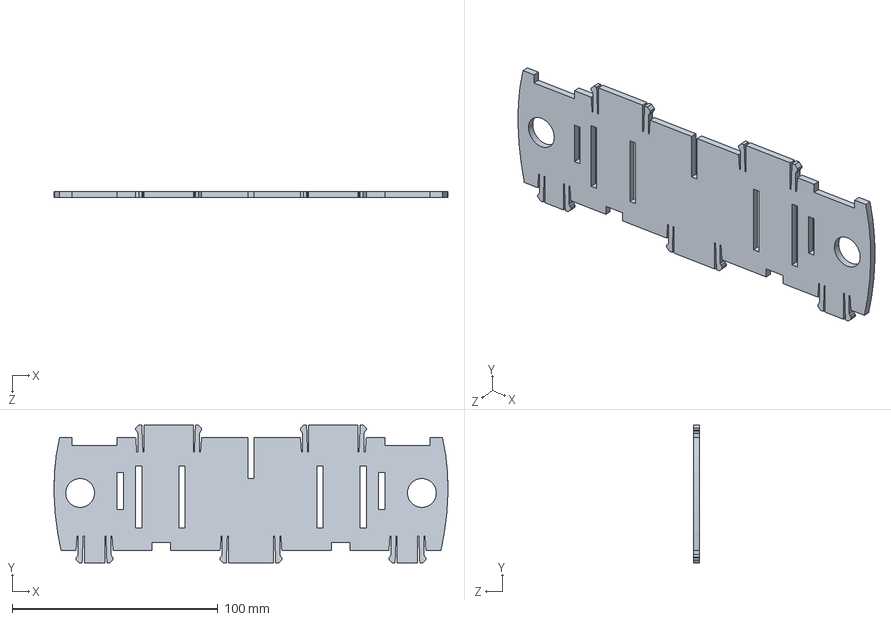
[picture p67: CAD file, 2015-02-17]
Frame/STEP/frame-3-7.step
191.4 x 67.0 x 3.00 mm
