OPSORO/Ono2/Mouth/STEP/mouth-frame-4.step

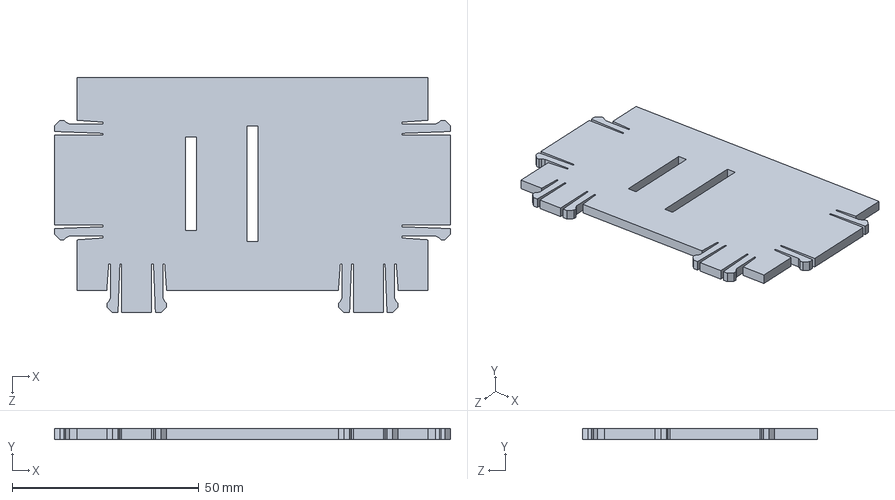
[picture p68: CAD file, 2015-02-17]
Mouth/STEP/mouth-frame-4.step
106.0 x 3.00 x 63.0 mm
