OPSORO/Ono2/Other components/Joint/STL/joint - joint-idler-base-1.STL

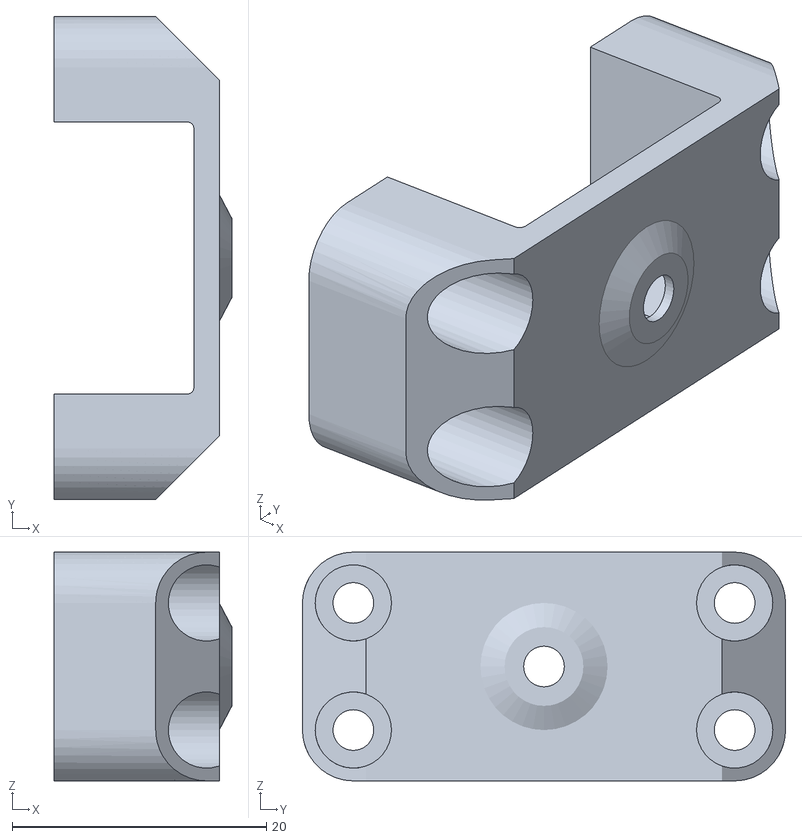
[picture p70: CAD file, 2015-02-17]
Other components/Joint/STL/joint - joint-idler-base-1.STL
14.0 x 38.0 x 18.0
