OPSORO/Ono2/Other components/panel-mount-ethernet.SLDPRT

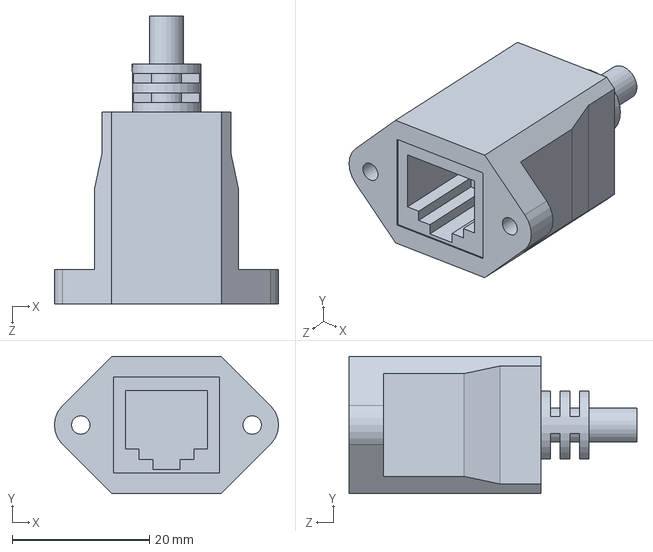
[picture p71: CAD file, 2015-08-07]
Other components/panel-mount-ethernet.SLDPRT
32.7 x 20.0 x 42.0 mm
