OPSORO/Ono2/Other components/STEP/servo-horn-round.step

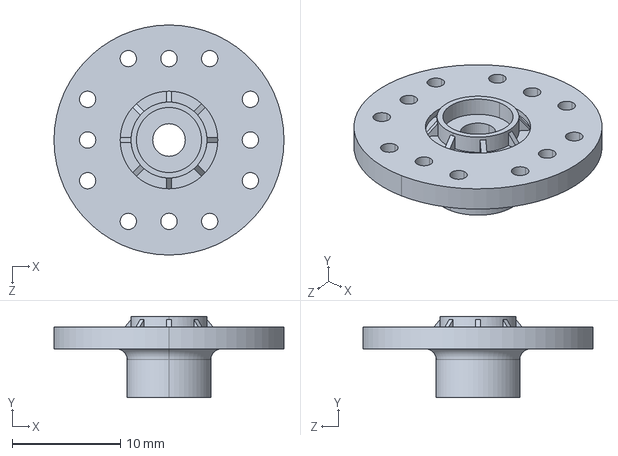
[picture p72: CAD file, 2015-02-17]
Other components/STEP/servo-horn-round.step
21.2 x 7.50 x 21.2 mm
