OPSORO/Ono2/Other components/Workshop-base/STEP/standoff-m3x40.step

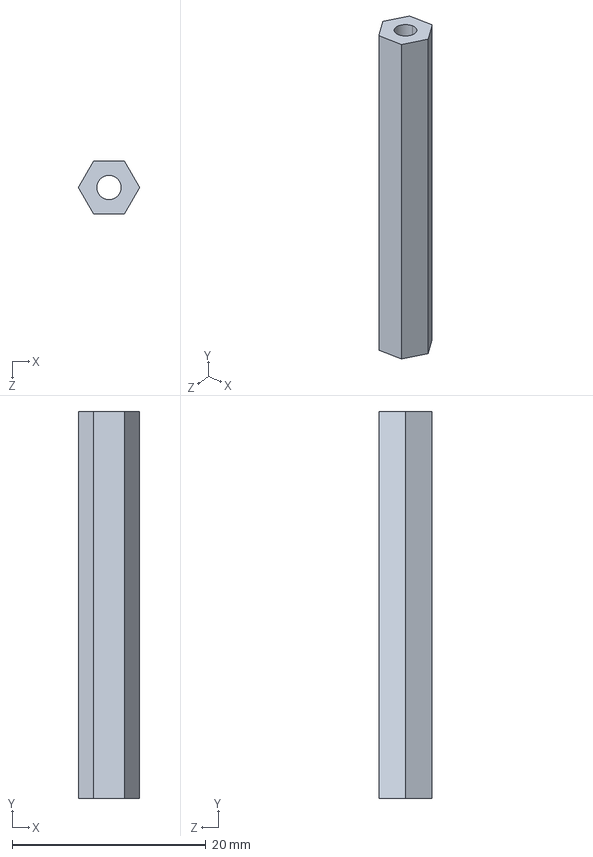
[picture p73: CAD file, 2015-02-17]
Other components/Workshop-base/STEP/standoff-m3x40.step
6.35 x 40.0 x 5.50 mm
