OPSORO/Ono2/Eye/eyelid-servo-gear-printed.SLDPRT

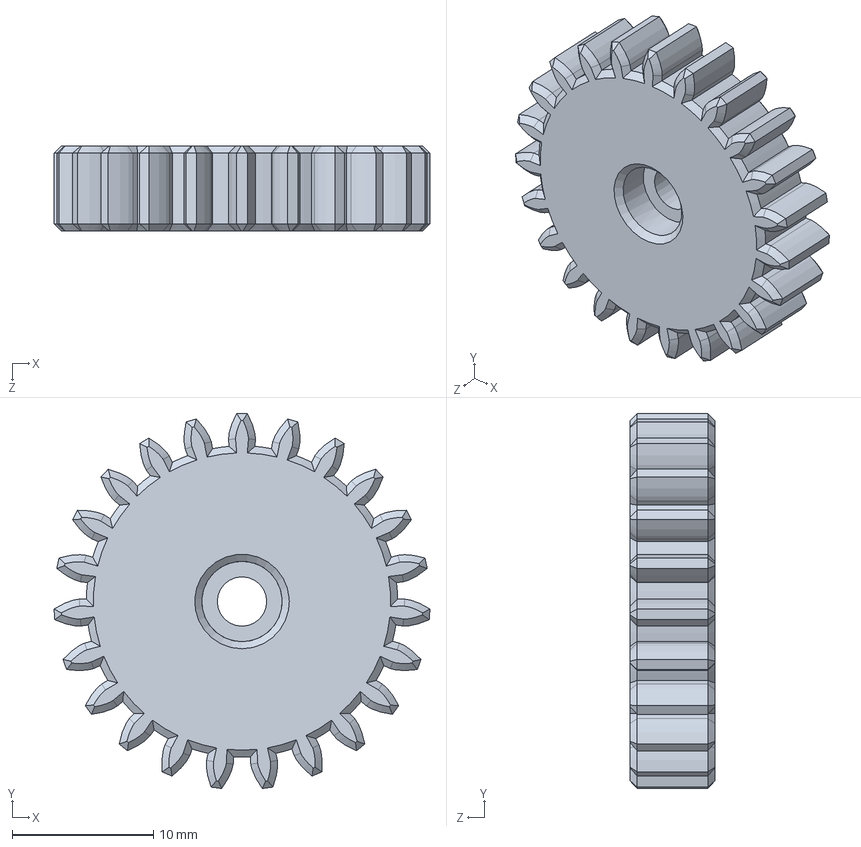
[picture p74: CAD file, 2014-09-25]
Eye/eyelid-servo-gear-printed.SLDPRT
26.6 x 26.6 x 6.00 mm
