OPSORO/Ono2/Eyebrow/lever-outer-printed-horn.SLDPRT

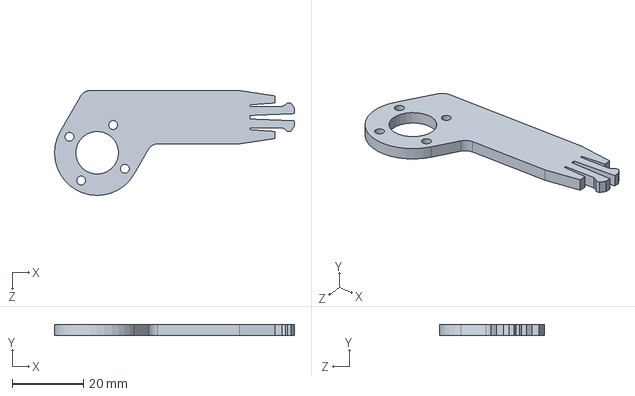
[picture p75: CAD file, 2014-09-25]
Eyebrow/lever-outer-printed-horn.SLDPRT
67.5 x 3.00 x 29.5 mm
