OPSORO/Ono2/Eyebrow/STEP/eyebrow-frame-3.step

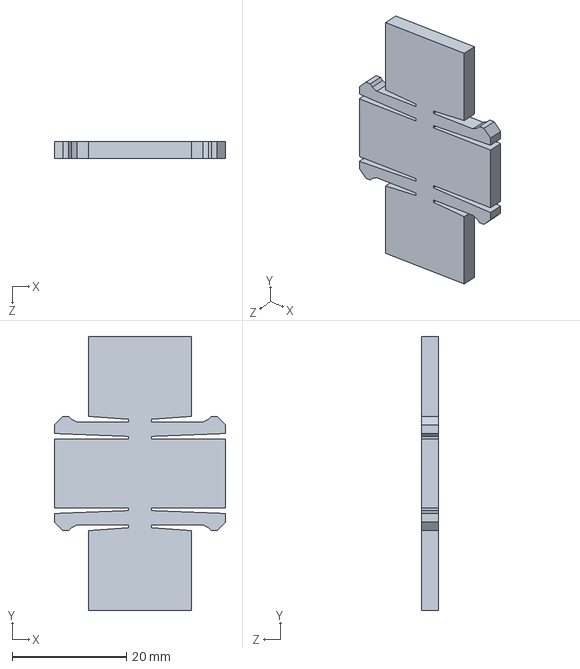
[picture p76: CAD file, 2015-02-17]
Eyebrow/STEP/eyebrow-frame-3.step
30.0 x 48.0 x 3.00 mm
