OPSORO/Ono2/(list of files, cad)

Other CAD files:
Other components/RaspberryPi/raspberry_pi__SD_reader_assembly.sldasm
Other components/RaspberryPi/raspberry_pi__HDMI_socket.sldasm
Other components/RaspberryPi/raspberry_pi__micro_USB.sldasm
Other components/RaspberryPi-B+/raspberry_pi_B+_(P1).SLDASM
Other components/RaspberryPi/raspberry_pi__USB_x2.sldasm
Other components/RaspberryPi/raspberry_pi__15_pin_FFC_Connector.sldasm
STL/ono - raspberrypi_b_+_(assembly)-1 raspberry_pi_B+_(microsd2)-1.STL
STL/ono - raspberrypi_b_+_(assembly)-1 raspberry_pi_B+_(CI_Board)-1.STL
STL/ono - raspberrypi_b_+_(assembly)-1 raspberry_pi_B+_(15_pin_FFC_Connector)-2 raspberry_pi__15_pin_FFC_Connector_pins-6-1.STL
STL/ono - raspberrypi_b_+_(assembly)-1 raspberry_pi_B+_(15_pin_FFC_Connector)-2 raspberry_pi__15_pin_FFC_Connector_pins-12-1.STL
STL/ono - raspberrypi_b_+_(assembly)-1 raspberry_pi_B+_(HDMI_socket)-1 raspberry_pi__HDMI_socket_small_pin-3-1.STL
STL/ono - raspberrypi_b_+_(assembly)-1 raspberry_pi_B+_(HDMI_socket)-1 raspberry_pi__HDMI_socket_large_pin-8-1.STL
STL/ono - raspberrypi_b_+_(assembly)-1 raspberry_pi_B+_(15_pin_FFC_Connector)-1 raspberry_pi__15_pin_FFC_Connector_pins-8-1.STL
STL/ono - raspberrypi_b_+_(assembly)-1 raspberry_pi_B+_(HDMI_socket)-1 raspberry_pi__HDMI_socket_small_pin-2-1.STL
STL/ono - raspberrypi_b_+_(assembly)-1 raspberry_pi_B+_(15_pin_FFC_Connector)-1 raspberry_pi__15_pin_FFC_Connector_pins-11-1.STL
STL/ono - raspberrypi_b_+_(assembly)-1 raspberry_pi_B+_(HDMI_socket)-1 raspberry_pi__HDMI_socket_large_pin-3-1.STL
STL/ono - raspberrypi_b_+_(assembly)-1 raspberry_pi_B+_(bar_180_2x20)-1.STL
STL/ono - raspberrypi_b_+_(assembly)-1 raspberry_pi_B+_(HDMI_socket)-1 raspberry_pi__HDMI_socket_large_pin-9-1.STL
STL/ono - raspberrypi_b_+_(assembly)-1 raspberry_pi_B+_(15_pin_FFC_Connector)-2 raspberry_pi__15_pin_FFC_Connector_body-1-1.STL
STL/ono - raspberrypi_b_+_(assembly)-1 raspberry_pi_B+_(HDMI_socket)-1 raspberry_pi__HDMI_socket_large_pin-5-1.STL
STL/ono - raspberrypi_b_+_(assembly)-1 raspberry_pi_B+_(15_pin_FFC_Connector)-2 raspberry_pi__15_pin_FFC_Connector_pins-9-1.STL
STL/ono - raspberrypi_b_+_(assembly)-1 raspberry_pi_B+_(HDMI_socket)-1 raspberry_pi__HDMI_socket_large_pin-10-1.STL
STL/ono - raspberrypi_b_+_(assembly)-1 raspberry_pi_B+_(15_pin_FFC_Connector)-1 raspberry_pi__15_pin_FFC_Connector_pins-12-1.STL
STL/ono - raspberrypi_b_+_(assembly)-1 raspberry_pi_B+_(HDMI_socket)-1 raspberry_pi__HDMI_socket_small_pin-5-1.STL
STL/ono - raspberrypi_b_+_(assembly)-1 raspberry_pi_B+_(15_pin_FFC_Connector)-1 raspberry_pi__15_pin_FFC_Connector_pins-6-1.STL
STL/ono - raspberrypi_b_+_(assembly)-1 raspberry_pi_B+_(15_pin_FFC_Connector)-2 raspberry_pi__15_pin_FFC_Connector_pins-10-1.STL
STL/ono - raspberrypi_b_+_(assembly)-1 raspberry_pi_B+_(HDMI_socket)-1 raspberry_pi__HDMI_socket_small_pin-9-1.STL
STL/ono - raspberrypi_b_+_(assembly)-1 raspberry_pi_B+_(15_pin_FFC_Connector)-2 raspberry_pi__15_pin_FFC_Connector_pins-4-1.STL
STL/ono - raspberrypi_b_+_(assembly)-1 raspberry_pi_B+_(15_pin_FFC_Connector)-2 raspberry_pi__15_pin_FFC_Connector_pins-13-1.STL
STL/ono - raspberrypi_b_+_(assembly)-1 raspberry_pi_B+_(HDMI_socket)-1 raspberry_pi__HDMI_socket_large_pin-7-1.STL
STL/ono - raspberrypi_b_+_(assembly)-1 raspberry_pi_B+_(15_pin_FFC_Connector)-1 raspberry_pi__15_pin_FFC_Connector_pins-13-1.STL
STL/ono - raspberrypi_b_+_(assembly)-1 raspberry_pi_B+_(15_pin_FFC_Connector)-1 raspberry_pi__15_pin_FFC_Connector_pins-14-1.STL
STL/ono - raspberrypi_b_+_(assembly)-1 raspberry_pi_B+_(15_pin_FFC_Connector)-2 raspberry_pi__15_pin_FFC_Connector_pins-2-1.STL
STL/ono - raspberrypi_b_+_(assembly)-1 raspberry_pi_B+_(15_pin_FFC_Connector)-2 raspberry_pi__15_pin_FFC_Connector_pins-7-1.STL
STL/ono - raspberrypi_b_+_(assembly)-1 raspberry_pi_B+_(15_pin_FFC_Connector)-2 raspberry_pi__15_pin_FFC_Connector_pins-15-1.STL
STL/ono - raspberrypi_b_+_(assembly)-1 raspberry_pi_B+_(15_pin_FFC_Connector)-2 raspberry_pi__15_pin_FFC_Connector_pins-5-1.STL
STL/ono - raspberrypi_b_+_(assembly)-1 raspberry_pi_B+_(15_pin_FFC_Connector)-1 raspberry_pi__15_pin_FFC_Connector_locker-1-1.STL
STL/ono - raspberrypi_b_+_(assembly)-1 raspberry_pi_B+_(15_pin_FFC_Connector)-1 raspberry_pi__15_pin_FFC_Connector_pins-7-1.STL
STL/ono - raspberrypi_b_+_(assembly)-1 raspberry_pi_B+_(QFN64)-1.STL
STL/ono - raspberrypi_b_+_(assembly)-1 raspberry_pi_B+_(RJ45)-1.STL
STL/ono - raspberrypi_b_+_(assembly)-1 raspberry_pi_B+_(HDMI_socket)-1 raspberry_pi__HDMI_socket_small_pin-4-1.STL
STL/ono - raspberrypi_b_+_(assembly)-1 raspberry_pi_B+_(15_pin_FFC_Connector)-2 raspberry_pi__15_pin_FFC_Connector_pins-3-1.STL
STL/ono - raspberrypi_b_+_(assembly)-1 raspberry_pi_B+_(HDMI_socket)-1 raspberry_pi__HDMI_socket_large_pin-4-1.STL
STL/ono - raspberrypi_b_+_(assembly)-1 raspberry_pi_B+_(HDMI_socket)-1 raspberry_pi__HDMI_socket_large_pin-1-1.STL
STL/ono - raspberrypi_b_+_(assembly)-1 raspberry_pi_B+_(15_pin_FFC_Connector)-1 raspberry_pi__15_pin_FFC_Connector_pins-2-1.STL
STL/ono - raspberrypi_b_+_(assembly)-1 raspberry_pi_B+_(15_pin_FFC_Connector)-1 raspberry_pi__15_pin_FFC_Connector_pins-9-1.STL
STL/ono - raspberrypi_b_+_(assembly)-1 raspberry_pi_B+_(HDMI_socket)-1 raspberry_pi__HDMI_socket_small_pin-6-1.STL
STL/ono - raspberrypi_b_+_(assembly)-1 raspberry_pi_B+_(15_pin_FFC_Connector)-2 raspberry_pi__15_pin_FFC_Connector_pins-14-1.STL
STL/ono - raspberrypi_b_+_(assembly)-1 raspberry_pi_B+_(15_pin_FFC_Connector)-2 raspberry_pi__15_pin_FFC_Connector_pins-8-1.STL
STL/ono - raspberrypi_b_+_(assembly)-1 raspberry_pi_B+_(HDMI_socket)-1 raspberry_pi__HDMI_socket_large_pin-6-1.STL
STL/ono - raspberrypi_b_+_(assembly)-1 raspberry_pi_B+_(USB_x2)-1 raspberry_pi_B+_(USB_x2_part1)-1-1.STL
STL/ono - raspberrypi_b_+_(assembly)-1 raspberry_pi_B+_(15_pin_FFC_Connector)-1 raspberry_pi__15_pin_FFC_Connector_pins-10-1.STL
STL/ono - raspberrypi_b_+_(assembly)-1 raspberry_pi_B+_(HDMI_socket)-1 raspberry_pi__HDMI_socket_small_pin-7-1.STL
STL/ono - raspberrypi_b_+_(assembly)-1 raspberry_pi_B+_(USB_x2)-2 raspberry_pi_B+_(USB_x2_part2)-1-1.STL
STL/ono - raspberrypi_b_+_(assembly)-1 raspberry_pi_B+_(15_pin_FFC_Connector)-1 raspberry_pi__15_pin_FFC_Connector_pins-15-1.STL
STL/ono - raspberrypi_b_+_(assembly)-1 raspberry_pi_B+_(audio_video2)-1.STL
STL/ono - raspberrypi_b_+_(assembly)-1 raspberry_pi_B+_(15_pin_FFC_Connector)-1 raspberry_pi__15_pin_FFC_Connector_pins-4-1.STL
STL/ono - raspberrypi_b_+_(assembly)-1 raspberry_pi_B+_(microsd_slot2)-1.STL
STL/ono - raspberrypi_b_+_(assembly)-1 raspberry_pi_B+_(15_pin_FFC_Connector)-1 raspberry_pi__15_pin_FFC_Connector_pins-5-1.STL
STL/ono - raspberrypi_b_+_(assembly)-1 raspberry_pi_B+_(15_pin_FFC_Connector)-1 raspberry_pi__15_pin_FFC_Connector_pins-1-1.STL
STL/ono - raspberrypi_b_+_(assembly)-1 raspberry_pi_B+_(15_pin_FFC_Connector)-1 raspberry_pi__15_pin_FFC_Connector_pins-3-1.STL
STL/ono - raspberrypi_b_+_(assembly)-1 raspberry_pi_B+_(15_pin_FFC_Connector)-2 raspberry_pi__15_pin_FFC_Connector_pins-1-1.STL
STL/ono - raspberrypi_b_+_(assembly)-1 raspberry_pi_B+_(HDMI_socket)-1 raspberry_pi__HDMI_socket_small_pin-1-1.STL
Frame/STL/frame-mbp.STL
Other components/RaspberryPi-B+/raspberry_pi__HDMI_socket_small_pin.SLDPRT
Other components/RaspberryPi/raspberry_pi__diode_10_pins.sldprt
Eye/STL/eye - eye-frame-spacer-1-1.STL
Eyebrow/STL/eyebrow - textile-snap-5.STL
Frame/STEP/psu-spacer.step
Other components/RaspberryPi-B+/raspberry_pi_B+_(micro_USB_contacts).SLDPRT
Other components/RaspberryPi/raspberry_pi__SD_reader_pin1.sldprt
Eye/eyelid-servo-gear-lasered-b.SLDPRT
Mouth/lever-outer-l-towerpro-horn.SLDPRT
Other components/RaspberryPi/raspberry_pi__HDMI_socket_small_pin.sldprt
Eye/STEP/eye-frame-spacer.step
Eye/STEP/eye-frame-1.step
Eye/STEP/eye-frame-2.step
Eye/STEP/eye-frame-3.step
Eye/STEP/eye-frame-4.step
Eye/STEP/eye-frame-mbp.step
Eye/STEP/eye-shell-r.step
Eye/STEP/eye-shell.step
Eye/STEP/eyelid-gear-l.step
Eye/STEP/eyelid-gear.step
Eye/STEP/eyelid-idler-l.step
Eye/STEP/eyelid-idler.step
Eye/STEP/eyelid-lower.step
Eye/STEP/eyelid-servo-gear.step
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
