OPSORO/Ono2/(commit log)

2014-09-25 Initial release of Ono V2!
    [Foam.3dm, STEP_raspberrypi_b_assembly_mounting_holes.SLDASM, balljoint-ball.SLDPRT, balljoint-housing.SLDPRT, balljoint.SLDASM, base-shape.SLDPRT, bearing-f623.SLDPRT, eye-frame-1.sldprt]
2014-12-22 Modified frame so USB WiFi dongle fits.
    [frame-1-1.sldprt, frame-1-10.sldprt, frame-1-11.sldprt, frame-1-12.sldprt, frame-1-13.sldprt, frame-1-14.sldprt, frame-1-15.sldprt, frame-1-16.sldprt]
2014-12-22 Snap-together eyelid, upgraded eye servo horns
    [eye-laser.DXF, eye-laser.SLDDRW, eye.sldasm, eyelid-gear.SLDPRT, eyelid-gear.STL, eyelid-idler.SLDPRT, eyelid-idler.STL, eyelid-lower.SLDPRT]
2014-12-22 Corrected hole pattern in standard servo horn
    [servo-horn-2-arms.SLDPRT, servo-standard.SLDPRT]
2014-12-22 Added joint module for workshop - Experimental!
    [joint-frame-1.sldprt, joint-frame-2.sldprt, joint-frame-mbp.SLDPRT, joint-frame-spacer.SLDPRT, joint-frame-spacer.STL, joint-frame.sldasm, joint-idler-base.SLDPRT, joint-idler-base.STL]
2015-02-17 Updated Joint, added Workshop Base
    [coverplate.SLDPRT, joint-idler-base.SLDPRT, joint-idler-base.STL, joint-laser.DXF, joint-laser.SLDDRW, joint-mounting-plate.SLDPRT, joint.SLDASM, midplate.SLDPRT]
2015-02-17 Generated STL, STEP, DXFs for all components
    [balljoint - balljoint-ball-1.STL, balljoint - balljoint-housing-1.STL, balljoint-ball.STL, balljoint-ball.step, balljoint-housing.STL, balljoint-housing.step, balljoint.step, base-shape.STL]
2015-08-07 Updated frame
    New PSU mount, new ziptie openings, reinforced feet and neck, hole
    pattern for RPi B+, panel-mount ethernet connector, extra openings for
    cables, fixed nut traps for speaker, smaller power switch, new LED
    holder, removed "active" LED
    [eye.sldasm, eyebrow.sldasm, frame-1-1.sldprt, frame-1-10.sldprt, frame-1-11.sldprt, frame-1-12.sldprt, frame-1-13.sldprt, frame-1-14.sldprt]
2015-08-10 Updated servo levers to use standard TowerPro horns
    After some abuse, the printed servo horns had a tendency to strip,
    causing the horn to spin freely. For this reason, printed horns have
    been replaced by the injection moulded horns that come with the servos.
    Lever files for printed servo horns are still available, however.
    [eyebrow - eyebrow-frame-1-1.STL, eyebrow - eyebrow-frame-2-1.STL, eyebrow - eyebrow-frame-3-1.STL, eyebrow - eyebrow-frame-4-1.STL, eyebrow - lever-inner-towerpro-horn-1.STL, eyebrow - lever-outer-towerpro-horn-1.STL, eyebrow - servo-horn-towerpro-1-arm-1.STL, eyebrow - servo-horn-towerpro-1-arm-2.STL]
2015-08-11 Updated eye module to use injection moulded servo horns
    [eye - balljoint-ball-1.STL, eye - balljoint-ball-2.STL, eye - balljoint-ball-3.STL, eye - balljoint-ball-5.STL, eye - balljoint-housing-1.STL, eye - balljoint-housing-2.STL, eye - balljoint-housing-3.STL, eye - balljoint-housing-4.STL]
2015-08-11 Added laser-cut eyelid-servo-gear
    Upgrade for the printed version. Some tweaking may be required to cut
    the servo spline on your laser cutter.
    [eye - balljoint-ball-1-1.STL, eye - balljoint-ball-2-1.STL, eye - balljoint-ball-3-1.STL, eye - balljoint-ball-5-1.STL, eye - balljoint-housing-1-1.STL, eye - balljoint-housing-2-1.STL, eye - balljoint-housing-3-1.STL, eye - balljoint-housing-4-1.STL]
2015-08-11 Added left/right indicators to 3D printed parts
    [eye - eye-frame-spacer-1-1.STL, eye - eye-frame-spacer-3.STL, eye - eyelid-servo-gear-lasered-a-1-1.STL, eye - eyelid-servo-gear-lasered-b-1-1.STL, eye - hex nut style 1 gradeab_iso-1-1.STL, eye - hex nut style 1 gradeab_iso-2-1.STL, eye - socket head cap screw_iso-40-1.STL, eye - socket head cap screw_iso-41-1.STL]
2015-10-12 Frame tweaks
    [frame-1-1.sldprt, frame-1-10.sldprt, frame-1-11.sldprt, frame-1-12.sldprt, frame-1-13.sldprt, frame-1-14.sldprt, frame-1-15.sldprt, frame-1-16.sldprt]
